liuba688/diansai-simulation/vision/training/analysis/assets/scene_0004_focus_sample.png

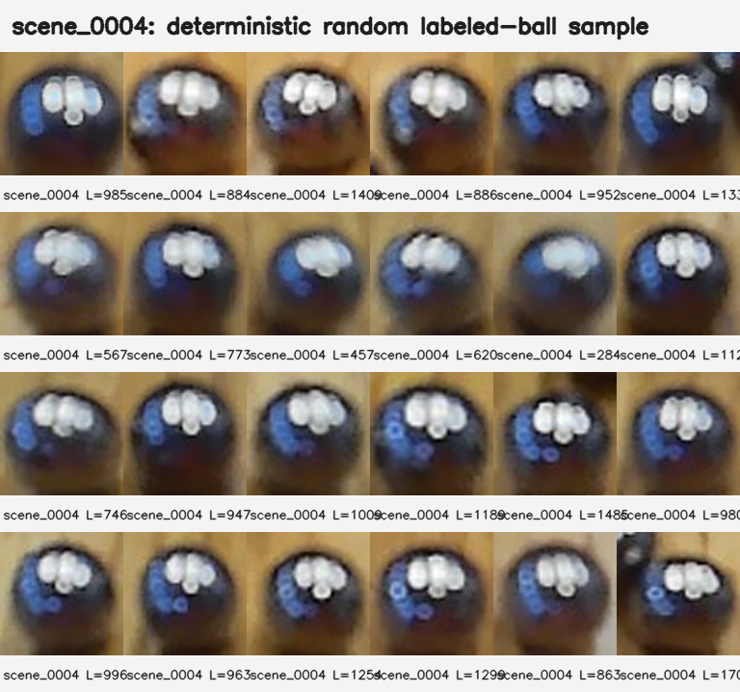
vision/training/analysis/assets/scene_0004_focus_sample.png
