liuba688/diansai-simulation/maixcam_ball_car/README.md

# MaixCAM 钢球视觉端

本目录保留完整钢球模型、目标跟踪、显示和 UART2 协议实现。视觉端只提供测量：
红框表示预警目标，绿框表示已连续确认并可进入控制。运动决策、速度闭环、倒退和
重新捕线均由 MSPM0G3507 执行。

通信为 UART1 115200，对接小车 UART2。当前系统不包含电磁铁或蓝牙控制。
