liuba688/diansai-simulation/PCB接线与引脚速查.md

# MSPM0G3507 终版小车 PCB 接线与引脚速查

> 用途：供人和 AI 快速查询板载接口、MCU 引脚及电气限制。后续开发优先查本文件，不从 Gerber 猜网络。  
> 原理图版本：`2026-06-13`，板名“2026电赛天猛星最终版”，V1.0。  
> 最后核对：2026-07-29（已与正式工程当前源码及 2026 H 题需求复核）。

## 1. 信息来源与使用规则

- **网络连接唯一依据**：`D:\ai embody\TI preparation\PCB\TI板卡\原理图文件\SCH_Schematic1_2026-06-13.pdf`
- **PCB 成品资料**：`D:\ai embody\TI preparation\PCB\TI板卡\Gerber2\10.zip`
- **工程引脚限制**：各工程下的 `project\尽量不要使用的引脚.txt`
- **实机修正优先级**：实机测量/已验证结果 > 2026-06-13 原理图 > 本文 > Gerber 丝印推断。
- 插头方向必须以 PCB 方形焊盘、数字 `1` 或连接器缺口确认；不要仅凭“从左到右”判断。
- 若本文与实物不一致，先停止上电并记录接口名、丝印、线序和测量结果，再更新本文。

## 2. 电源与共地

| 网络 | 用途 | 关键说明 |
|---|---|---|
| `12V_POWER` | 外部 12 V 输入开关前网络 | 经 U21 开关后成为 `12V` |
| `12V` | TB6612 VM、电机电源、UART3/UART5 电机兼容口 | 禁止接普通 5 V 串口模块 |
| `+5V` | TB6612 逻辑、编码器、OLED/IMU/部分接口供电 | USB-TTL 5 V 不得与已供电载板并联 |
| `VCC/3V3` | MSPM0 逻辑电源 | MCU GPIO 是否 5 V 容忍必须按器件资料确认 |
| `GND` | 全板公共地 | 外部电源、烧录器、USB-TTL 通信时必须共地 |

### 电源接口

| 接口 | 引脚/网络 | 用途 |
|---|---|---|
| U43（XT60） | 1=`12V_POWER`，2=`GND` | 主电源输入 |
| U21 | `12V_POWER` → 开关 → `12V` | 主电源开关 |
| U19 | IN+=`12V`，IN-=`GND`，OUT+=`+5V`，OUT-=`GND` | 12 V 转 5 V 模块 |
| CN14 | 1=`12V`，2=`GND` | 12 V 引出 |
| CN13 | 1=`+5V`，2=`GND` | 5 V 引出 |

### 上电安全

- 3S/12 V/5 V 链路和实车电机运行已验证，正式工程使用 `TB6612_OUTPUT_ENABLE=1`；上电默认 PWM=0。旧程序曾由蓝牙 `1` 启动并等待 3 秒，该流程与正式 H 题无关，比赛版必须改为实体按键启动并同步开始计时。
- 外部电源给 PCB 和电机供电时，烧录器只接 GND、SWDIO、SWCLK、NRST、VTref；关闭或断开烧录器 target power。
- 当前正式固件已停用 USB-TTL/UART3 调试、遥测和日志导出；比赛板不连接 USB-TTL。历史诊断接法仅供旧版本排障参考。
- 电机额定电流 1 A、堵转电流 2 A；当前已启用 TB6612 并完成实车巡线，后续高负载运行仍需观察电流和散热余量。

## 3. 当前正式功能引脚总表

| 模块/信号 | MCU 引脚 | 外设/功能 | 当前状态 |
|---|---|---|---|
| 历史调试 UART TX/RX | PB6/PB7 | UART1 | 正式固件不使用 |
| 历史 PID/日志 TX/RX | PB2/PB3 | UART3，板载 UART4 接口 | 正式固件不初始化、不收发；USB-TTL 停用 |
| 蜂鸣器 | PA7 | GPIO | 低电平触发 |
| OLED SCL | PA31 | 软件 I2C | 已验证 |
| OLED SDA | PA28 | 软件 I2C | 已验证 |
| IMU SCL | PA1 | 软件 I2C | 新 MPU6050 已完成通信、标定和 Angle Hold 实车验收 |
| IMU SDA | PA0 | 软件 I2C | 新 MPU6050 已完成通信、标定和 Angle Hold 实车验收 |
| IMU INT | PB4 | GPIO/中断 | 原理图已接，当前非必需 |
| 状态 LED | PB16 | GPIO | 当前程序心跳 |
| 核心板 LED | PA14 | GPIO | 与 MOTOR1 编码器 B 共用，不作为正式心跳 |
| 电机 PWM A | PA12 | TIMG0_C0 | TB6612 PWMA |
| 电机方向 AIN1 | PB19 | GPIO | MOTOR2 驱动方向；与正式 `tb6612.c` 一致 |
| 电机方向 AIN2 | PB17 | GPIO | MOTOR2 驱动方向；与正式 `tb6612.c` 一致 |
| 电机 PWM B | PA13 | TIMG0_C1 | TB6612 PWMB |
| 电机方向 BIN1 | PA16 | GPIO | MOTOR1 驱动方向 |
| 电机方向 BIN2 | PB24 | GPIO | MOTOR1 驱动方向 |
| MOTOR1 编码器 A | PA25 | GPIO 双边沿中断 | 已纠正并验证 |
| MOTOR1 编码器 B | PA14 | GPIO 双边沿中断 | 已纠正并验证 |
| MOTOR2 编码器 A | PA26 | GPIO 双边沿中断 | 已验证 |
| MOTOR2 编码器 B | PA27 | GPIO 双边沿中断 | 已验证 |
| CY-DXJ8 OUT1 | PB25 / H55-1 | GPIO 输入 | 新分配，待实测 |
| CY-DXJ8 OUT2 | PB18 / H55-2 | GPIO 输入 | 新分配，待实测 |
| CY-DXJ8 OUT3 | PB21 / H55-3 | GPIO 输入 | 新分配，待实测 |
| CY-DXJ8 OUT4 | PB22 / H55-4 | GPIO 输入 | 新分配，待实测 |
| CY-DXJ8 OUT5 | PA30 / H55-5 | GPIO 输入 | 新分配，待实测 |
| CY-DXJ8 OUT6 | PB0 / H55-6 | GPIO输入 | 新分配，待实测 |
| CY-DXJ8 OUT7 | PB1 / H55-7 | GPIO输入 | 新分配，待实测 |
| CY-DXJ8 OUT8 | PB14 / H55-10 | GPIO输入 | 新分配，待实测 |
| 菜单键 UP | PB13 / H56-4 | GPIO 输入、内部上拉 | 低电平按下，实机验证通过 |
| 菜单键 DOWN | PB23 / H56-3 | GPIO 输入、内部上拉 | 低电平按下，实机验证通过 |
| 菜单键 OK/比赛启动 | PB26 / H56-2 | GPIO 输入、内部上拉 | 低电平按下，实机验证通过 |
| 菜单键 BACK/急停 | PB27 / H56-1 | GPIO 输入、内部上拉 | 低电平按下，实机验证通过 |
| 摆杆执行器 PWM | PA22（U35） | TIMA0_C1 | H 题推荐预留，尚未接线和实测 |
| 摄像头数据 TX→主控 | PB3（UART3 RX） | 板载 UART4 的 RX 脚 | H 题推荐预留，联调时须先断开 USB-TTL |
| 主控数据 TX→摄像头 | PB2（UART3 TX） | 板载 UART4 的 TX 脚 | 可选；若摄像头只单向上传球坐标可不接 |

> “代码暂定/推荐预留”不等于已经完成接线。比赛新增模块接线后必须把本表状态改为“已实测”，同时记录接口方向、电压和通信参数。

## 4. 串口接口

### 普通 5 V 四针串口

| 板载接口 | 1 脚 | 2 脚 | 3 脚 | 4 脚 | MCU 外设 |
|---|---|---|---|---|---|
| UART0 | +5V | GND | RX=PA1 | TX=PA0 | UART0 |
| UART1 | +5V | GND | RX=PB7 | TX=PB6 | UART1 |
| UART2 | +5V | GND | RX=PA24 | TX=PA23 | UART2 |

- 当前正式比赛固件不启用 USB-TTL 调试串口。UART0/1/2 的历史实测结论保留，但不代表当前固件会输出数据。

### 电机兼容/特殊串口

| 板载接口 | 1 脚 | 2 脚 | 3 脚 | 4 脚 | 说明 |
|---|---|---|---|---|---|
| UART3 | TX=PA23 | RX=PA24 | GND | 12V | 与 UART2 共用信号，含 12 V |
| UART4（Zigbee） | +5V | RX=PB3 | TX=PB2 | GND | 实际对应 MCU UART3 |
| UART5 | TX=PB6 | RX=PB7 | GND | 12V | 与 UART1 共用信号，含 12 V |

> **高风险**：UART3/UART5 的 4 脚是 12 V，不是 5 V。普通 USB-TTL 不得插到这两个接口的电源脚。

## 5. TB6612 与双电机接口

### TB6612 模块排针

| TB6612 信号 | PCB 网络/MCU | 说明 |
|---|---|---|
| VM | 12V | 电机功率电源 |
| VCC | +5V | 逻辑电源 |
| GND | GND | 两侧均有地 |
| PWMA | PA12 / TIMG0_C0 | MOTOR2 PWM |
| AIN1 | PB19 | MOTOR2 方向 |
| AIN2 | PB17 | MOTOR2 方向 |
| AO1/AO2 | MOTOR2 M4/M3 | MOTOR2 电机两端 |
| STBY | +5V | 硬件常使能 |
| PWMB | PA13 / TIMG0_C1 | MOTOR1 PWM |
| BIN1 | PA16 | MOTOR1 方向 |
| BIN2 | PB24 | MOTOR1 方向 |
| BO1/BO2 | MOTOR1 M1/M2 | MOTOR1 电机两端 |

### 六针电机接口线序

以下为原理图符号**自上而下**的网络顺序；实际插线前仍须以 PCB 的 1 脚标识确认物理方向。

| 接口 | 自上而下网络顺序 | 编码器引脚 |
|---|---|---|
| MOTOR1 | `M2/BO2`、`+5V`、`A/PA25`、`B/PA14`、`GND`、`M1/BO1` | A=PA25，B=PA14 |
| MOTOR2 | `M4/AO1`、`+5V`、`A/PA26`、`B/PA27`、`GND`、`M3/AO2` | A=PA26，B=PA27 |

### 电机与编码器参数

- 减速比：56:1；额定转速：178 RPM。
- 额定电流：1 A；堵转电流：2 A。
- 额定转矩：6.5 N·m；最大转矩：9 N·m。
- 编码器推荐 5 V 供电，本体为 AB 两相；每电机轴 11 个 AB 周期。
- MCU 软件四倍频后理论输出轴计数：`11×56×4=2464 count/rev`。
- 两轴十圈实测平均：`2473.5 count/rev`；正式速度闭环按用户决定采用商家 `2450 count/rev`。
- 5 V 编码器的 AB 输出电平兼容性尚需确认：检查是否有板载调理、开漏上拉或 3.3 V 兼容输出。

## 6. 蜂鸣器、OLED 与 IMU

### 蜂鸣器 U3

| 引脚 | 网络 | 说明 |
|---|---|---|
| 1 | VCC/3.3V | 模块逻辑侧供电 |
| 2 | PA7 | 低电平触发 |
| 3 | GND | 地 |

### OLED

| 顺序 | 网络 | 说明 |
|---|---|---|
| 1 | GND | 地 |
| 2 | VCC | 电源 |
| 3 | SCL=PA31 | 软件 I2C |
| 4 | SDA=PA28 | 软件 I2C |

- 已验证为 SSD1306、128×64、I2C 地址 0x3C。

### IMU（U41，板上标注 MPU6050）

| 引脚 | 网络 | 当前用途 |
|---|---|---|
| 1 VCC | +5V | 模块供电 |
| 2 GND | GND | 地 |
| 3 SCL | PA1 | 软件 I2C SCL |
| 4 SDA | PA0 | 软件 I2C SDA |
| 5 XDA | NC | 未使用 |
| 6 XCL | NC | 未使用 |
| 7 AD0 | GND | I2C 地址选择为 0x68 |
| 8 INT | PB4 | 中断输出，当前非必需 |

- 当前模块为新换的 MPU6050/GY-521 类模块；I2C 7位地址为 `0x68`，驱动兼容 `WHO_AM_I=0x68`（MPU6050）和 `0x70`（MPU6500兼容器件）。当前新模块的实测身份值尚未单独留档，不得把旧模块的 `0x70` 当作新模块实测值。
- 配置：陀螺仪量程±2000 dps（16.4 LSB/(°/s)），加速度计量程±2 g（16384 LSB/g），DLPF约42 Hz，传感器采样率125 Hz，控制更新周期约10 ms。
- OLED菜单执行 `CALIBRATE YAW` 时整车必须静止；程序采集500点陀螺零偏和重力方向，用于倾斜安装下的车体竖直轴投影，耗时约2秒。
- Yaw符号约定（从车体上方俯视）：**逆时针旋转为正，顺时针旋转为负**。该约定已通过实车验证，禁止在接线或控制层再次反号。
- 当前正式角度比例系数为 `1.172`。Angle Hold实测：顺时针90°约`-90.7°`，逆时针90°约`+89.6°`，回到原朝向残差仅零点几度，已通过验收。

## 7. 舵机接口

四个 XH-3A 接口均为三针：1=信号、2=+5V、3=GND。

| 接口 | 1 脚信号 | 定时器通道 |
|---|---|---|
| U35 | PA22 | TIMA0_C1 |
| U39 | PA15 | TIMA0_C2 |
| U36 | PA17 | TIMA0_C3 |
| U34 | PA21 | TIMA0_C0 |

> PA21、PA23 属于核心板建议避免使用的特殊引脚；使用 PA21 舵机口前应核对核心板器件限制。

### H 题摆杆执行器推荐接法（尚未实测）

优先使用 U35，避免 PA21 特殊引脚：

| 执行器端 | 接到载板 | 说明 |
|---|---|---|
| PWM/S | U35-1，PA22 | TIMA0_C1；程序输出频率和脉宽必须与实际舵机匹配 |
| +5V/V+ | U35-2 或独立稳压 5～6 V | 小舵机可先空载测试；大扭矩舵机优先使用足够电流的独立稳压电源 |
| GND/- | U35-3/GND | 独立执行器电源必须与 MSPM0 载板共地 |

- 禁止把舵机接到 12 V。
- 禁止仅凭“5 V”判断板载降压模块一定带得动舵机；先测启动/堵转电流和 5 V 压降。
- 舵机首次测试必须拆下连杆或限制摆幅，确认中位和方向后再连接摆杆，防止顶死机构。
- 如果最终改用直流减速电机，不能直接接 PA22，必须增加合适的电机驱动器和位置反馈；确定器件后再补最终接线。

## 8. RGB 与扩展接口

### RGB 三针接口

| 接口 | 信号 | 电源 | 地 |
|---|---|---|---|
| U1 | PA14 | VCC | GND |
| U2 | PA18 | VCC | GND |
| U5 | PA2 | VCC | GND |

- PA14 同时连接核心板 LED，并在当前工程中作为 MOTOR1 编码器 B，不应再接 RGB 负载。

### 其余 IO

- H55：1=PB25，2=PB18，3=PB21，4=PB22，5=PA30，6=PB0，7=PB1，8=PB10，9=PB11，10=PB14。
- H56：菜单接线以载板实物方向和 2026-07-29 通断/上电实测为准：4=PB13，3=PB23，2=PB26，1=PB27。旧原理图摘录的编号方向与实物识别不一致，不再用于这四个菜单键。
- H51/H52/H53/H54/H60/H61 为辅助排针/引出位；原理图未给出统一功能名，未确认前不要按位置猜用途。

## 8.1 CY-DXJ8 八路灰度模块（当前正式方案）

CY-DXJ8 使用 `OUT1～OUT8 + 5V + GND` 共十根线，八路信号直接并行读取。OUT8 继续沿用 H55-10/PB14；PB10/PB11 不再作为当前菜单键：

| CY-DXJ8 | 载板/MCU | 软件位 | 方向 | 状态 |
|---|---|---:|---|---|
| `+5V` | CN13或可靠的载板`+5V` | - | 载板→模块 | 待接线 |
| `GND` | 载板`GND` | - | 共地 | 待接线 |
| `OUT1` | H55-1 / PB25 | bit7（最右） | 模块→MCU | 方向已确认 |
| `OUT2` | H55-2 / PB18 | bit6 | 模块→MCU | 方向已确认 |
| `OUT3` | H55-3 / PB21 | bit5 | 模块→MCU | 方向已确认 |
| `OUT4` | H55-4 / PB22 | bit4 | 模块→MCU | 方向已确认 |
| `OUT5` | H55-5 / PA30 | bit3 | 模块→MCU | 方向已确认 |
| `OUT6` | H55-6 / PB0 | bit2 | 模块→MCU | 方向已确认 |
| `OUT7` | H55-7 / PB1 | bit1 | 模块→MCU | 方向已确认 |
| `OUT8` | H55-10 / PB14 | bit0（最左） | 模块→MCU | 方向已确认 |

- 从车头朝前看，实物OUT8在最左、OUT1在最右；软件引脚表已反向排列，保持 `bit0=最左`、`bit7=最右`。
- 权重继续使用 `-350,-250,-150,-50,50,150,250,350`。
- **电平已实测**：白色地面输出低电平，黑线输出3.3 V高电平；当前 `LINE_SENSOR_ACTIVE_LEVEL=1` 和GPIO下拉输入配置正确。
- OUT高电平为3.3 V，可直接接MSPM0 GPIO，不需要额外分压或电平转换；模块电源仍接5 V并与载板共地。
- 先在轮胎离地状态观察 `mask/error`。从左到右扫过OUT8→OUT1时，预期掩码依次为 `01,02,04,08,10,20,40,80`；若按OUT1→OUT8扫描，则依次为 `80,40,20,10,08,04,02,01`。
- 旧 YB-MVX05 六线接法和已验收参数保留在历史文档和Git中，CY-DXJ8验收失败时可以回退。

## 8.2 四键菜单与比赛启动键（2026-07-31 当前配置）

正式工程恢复四个外部按键并关闭 B21 单键方案。四键配置为内部上拉、低电平按下；松开为高电平 `1`、按下为低电平 `0`。每个按键只需连接“对应 GPIO ↔ 按键 ↔ GND”，不得把按键另一端接 5 V。

| 功能 | MCU 引脚 | 电气接法 | H 题用途 |
|---|---|---|---|
| UP | PB13 / H56-4 | 按下时 PB13 与 GND 导通 | 菜单上移，已验证 |
| DOWN | PB23 / H56-3 | 按下时 PB23 与 GND 导通 | 菜单下移，已验证 |
| OK | PB26 / H56-2 | 按下时 PB26 与 GND 导通 | 确认/比赛启动，已验证 |
| BACK | PB27 / H56-1 | 按下时 PB27 与 GND 导通 | 急停/返回，已验证 |

- 四个信号连续位于 H56-4～H56-1，按键公共端接载板任意 GND。
- 短按事件在按键稳定释放后触发，建议按住约 0.1～0.5 s 后松开；UP/DOWN/OK 长按约 1 s 不会当作短按，BACK 长按用于停止。
- MOTOR2 编码器使用 `PA26/PA27`，菜单键使用 `PB26/PB27`，A/B 端口不同，不冲突。
- 曾用 `KEY TEST 0730` 诊断固件在 OLED 上逐键观察原始电平，四键均能正确切换；诊断模式随后关闭并恢复正式菜单。
- 题目要求实体按键启动时立即开始计时；旧蓝牙启动和 3 秒等待不能作为正式测试流程。
- 曾短暂尝试板载 B21 单键菜单，并把 OUT3 改到 PB10；该方案已撤销。当前 B21 恢复为 CY-DXJ8 OUT3，PB10 不用于 OUT3。

## 8.3 H 题摄像头、坐标通信与无线图传（推荐预留，尚未实测）

### 摄像头坐标到 MSPM0

HC-05 已正式放弃并应拆除/断开。需要摄像头通信时，复用板载 UART4（实际是 MCU UART3），并先断开 USB-TTL：

| 摄像头端 | 板载 UART4 | MCU | 说明 |
|---|---|---|---|
| TX | RX 脚 | PB3 / UART3 RX | 必接：摄像头向主控发送钢球位置 |
| RX | TX 脚 | PB2 / UART3 TX | 可选：主控发送目标位置或配置 |
| GND | GND | GND | 必须共地 |
| 电源 | +5V 或独立稳压电源 | - | 必须按摄像头铭牌确认，不能猜测 |

- 串口 TX/RX 必须交叉连接，通信双方统一波特率、数据位、停止位和校验方式。
- 接线前测量摄像头 UART 高电平，确认与 MSPM0 3.3 V GPIO 兼容；若输出为 5 V，必须加电平转换或分压。
- 摄像头只发送球坐标、有效标志和必要状态，不把视频流传入 MSPM0。
- 禁止 USB-TTL、摄像头或其他模块同时驱动 UART4，避免多个设备争用 PB2/PB3。

### 无线图传

- 图传发送模块和摄像头固定在车上；接收模块、显示和存储设备置于环形线路外。
- 图传画面必须覆盖整个 25 cm 摆杆，能看清钢球和刻度，并能完整录像、回放。
- 图传模块供电电压、极性和工作电流必须按实际型号标注后再接；当前没有确定型号，因此本文不能给出电源针序。
- 若图传与控制摄像头是两套设备，可以共用机械支架，但电源容量需分别核算；使用同一车载电源时必须共地并检查干扰。

## 8.4 当前整车接线完整性清单

| 子系统 | 接线说明是否完整 | 备注 |
|---|---|---|
| 主电源/5 V降压/共地 | 是 | 已实车验证 |
| TB6612与双电机 | 是 | 本次已纠正 AIN1/AIN2 文档顺序 |
| 双编码器 | 是 | 5 V输出电平裕量仍属长期风险 |
| CY-DXJ8 | 部分实测 | 十线并行接法、白底低/黑线3.3 V高、OUT8最左/OUT1最右已确认；整车巡线待验收 |
| OLED/蜂鸣器/UART1日志 | 是 | 已验证 |
| 四键 | 是 | PB13/PB23/PB26/PB27，松开1、按下0，OLED菜单实测正常 |
| 摆杆舵机 | 推荐方案已给出 | PA22/U35 尚未实测，最终执行器未冻结 |
| 摄像头坐标串口 | 推荐方案已给出 | PB2/PB3 尚未实测，联调时需先断开 USB-TTL |
| 无线图传 | 否 | 型号和针序未知，取得实物后必须补录 |
| MPU6050/HC-05 | 历史接线完整 | HC-05 已放弃并断开；MPU6050 与正式 H 题无关 |

## 9. 核心板 80 Pin 对照

| Pin | 网络 | Pin | 网络 | Pin | 网络 | Pin | 网络 |
|---:|---|---:|---|---:|---|---:|---|
| 1 | GND | 2 | GND | 41 | GND | 42 | +5V |
| 3 | PA0 | 4 | PA28 | 43 | GND | 44 | 3V3 |
| 5 | PA1 | 6 | PA31 | 45 | RST | 46 | PA18 |
| 7 | PA8 | 8 | PB4 | 47 | PB11 | 48 | PB14 |
| 9 | PA9 | 10 | PB5 | 49 | PB10 | 50 | PA7 |
| 11 | PB15 | 12 | PA10 | 51 | PB0 | 52 | PB1 |
| 13 | PB16 | 14 | PA11 | 53 | PA30 | 54 | GND |
| 15 | PB2 | 16 | PB12 | 55 | PB21 | 56 | PB22 |
| 17 | PB3 | 18 | PB13 | 57 | GND | 58 | +5V |
| 19 | DIO | 20 | CLK | 59 | GND | 60 | 3V3 |
| 21 | GND | 22 | 3V3 | 61 | PA2 | 62 | PA23 |
| 23 | GND | 24 | +5V | 63 | PB19 | 64 | PA21 |
| 25 | PB6 | 26 | PB7 | 65 | PB17 | 66 | PB18 |
| 27 | PB8 | 28 | PB9 | 67 | PA16 | 68 | PA17 |
| 29 | PA12 | 30 | PA13 | 69 | PA14 | 70 | PA15 |
| 31 | PB23 | 32 | PB26 | 71 | PB20 | 72 | PA22 |
| 33 | PB27 | 34 | PA29 | 73 | PB25 | 74 | PB24 |
| 35 | AGND | 36 | CHIP | 75 | PA25 | 76 | PA24 |
| 37 | GND | 38 | 3V3 | 77 | PA27 | 78 | PA26 |
| 39 | GND | 40 | +5V | 79 | GND | 80 | GND |

## 10. 核心板建议避免使用的引脚

- 建议避免：PA23、PA21、PA19、PA20、PA5、PA6、PA4、PA3。
- PA14 连接核心板 LED；当前又作为 MOTOR1 编码器 B，禁止再分配其他功能。
- 若必须使用 PA23/PA21，核心板说明要求移除 R8、R9、C14、C15 后才可正常使用；实际操作前必须再次核对核心板原理图。
- 载板虽然已将 PA23 引到 UART2/UART3、PA21 引到舵机 U34，但“已布线”不等于“可无条件使用”。

## 11. 已确认的易错点

- 旧记录曾把 MOTOR1 编码器写成 PA24/PA25；**正确值是 PA25/PA14**。
- 板载 `UART4` 是接口编号，实际对应 MCU UART3（PB2/PB3）。
- UART3 与 UART2 共用 PA23/PA24，但 UART3 接口带 12 V。
- UART5 与 UART1 共用 PB6/PB7，但 UART5 接口带 12 V。
- UART0 PA0/PA1 当前已被 IMU 软件 I2C 使用，正式调试串口必须用 UART1。
- 旧 IMU 已出现 `WHO_AM_I=FF`、三轴全零并明显发烫，当前已移除且禁止再次上电；LED 亮不代表芯片正常。
- 替换件选标准 GY-521 MPU6050，必须逐针确认顺序为 `VCC/GND/SCL/SDA/XDA/XCL/AD0/INT`，并确认排母插入方向使 VCC 对 VCC。相同针序反向插入仍会烧毁。
- 新模块首次只接控制板，先核对实际供电、电流、温升和 I2C 响应；确认正常后再接电机。新 GY-521 通常为 `WHO_AM_I=0x68`，软件需兼容旧模块的 0x70 和新模块的 0x68。
- MOTOR1/MOTOR2 与整车左右轮、正 PWM 与前进方向的关系仍须装车实测，不能仅凭接口编号推断。

## 12. AI 修改代码前检查清单

1. 先查“当前正式功能引脚总表”，确认没有重复占用。
2. 涉及电源时明确写出 3.3 V、5 V 或 12 V，不使用含糊的 `VCC` 代替。
3. 涉及 UART3/UART5 时先提示其接口含 12 V。
4. 涉及电机时确认主电源、左右轮映射、PWM 方向、编码器符号及 `TB6612_OUTPUT_ENABLE=1`。
5. 涉及编码器时固定使用 MOTOR1=PA25/PA14、MOTOR2=PA26/PA27。
6. 涉及 IMU 时保留 PA0/PA1，不把调试 UART 改回 UART0。
7. 新发现的实机线序或原理图差异必须同时更新本文件和《调试日志.md》。
