liuba688/diansai-simulation/开发进度.md

# MSPM0G3507 终版小车开发进度

> 本人和队友的逐日开发记录已合并到《开发历程合并时间线.md》。本文原有内容完整保留；
> 后续不得用短摘要覆盖历史，只能按日期追加或修正“当前状态”。

> 更新日期：2026-07-29
> 本文件只记录当前有效状态、已完成里程碑和真正未完成事项；历史排错过程见《调试日志.md》。
 AI工具每次做完任务必须及时更新文档，包括旧的内容更改和新的内容添加
> 2026-07-29 正式赛题已经发布。下文以 H 题为唯一主线；保留但不直接服务于本题的旧功能统一标记为“**与赛题无关**”，比赛期间暂停投入时间。

## 当前执行总计划（2026-07-29，后续调试以此为准）

### 分工与总体原则

- **本人：底盘与巡线主线**。2026-07-29 决定正式改用 CY-DXJ8 八路并行数字灰度，保留已经通过实车验证的双轮速度闭环和巡线外环结构，重新验收黑白电平、左右顺序和巡线参数；随后完成实体按键启动、OLED 计时、A 点终点识别、速度规划和停车偏差收敛。
- **队友：MaixCAM 视觉主线**。摄像头朝下，画面只覆盖水管和钢球；完成球心检测、像素到毫米标定、滤波、速度估计、丢球判断和串口输出。
- **共同完成：摆杆与滚球闭环**。先完成执行器中位、正负方向、角度限幅和开环测试，再完成静态回中、`O→+5 cm→-5 cm`、A-B 动态平衡、整圈中心平衡和任意指定位置。
- 三条线并行推进，不等视觉完全结束才测试执行器，也不等巡线全部结束才冻结通信协议。视觉未完成时用模拟坐标测试主控；主控未完成时视觉端用电脑串口记录验证。
- 每一步都设置独立验收门，验收通过后保存固件、参数、串口日志、照片和视频，不用单次最好结果代替重复测试。

### 接口冻结

MaixCAM 向 MSPM0 输出一维物理坐标，不再沿用旧“地面钢球接近/拾取”语义：

| 字段 | 定义 |
|---|---|
| `sequence` | 帧序号，用于发现丢帧或旧帧 |
| `position_mm` | 水管中心为 0，画面左侧为负、右侧为正 |
| `velocity_mm_s` | 滤波后的钢球轴向速度 |
| `confidence` | 视觉置信度 |
| `valid` | 本帧位置是否可用于控制 |
| `fault` | 丢球、越界或视觉内部故障 |
| `crc` | 串口帧校验 |

- 视觉检测与发送目标频率：30～50 Hz；MSPM0 滚球控制先使用 20 ms 周期。
- 超过 100～200 ms 无有效新帧、连续丢球或坐标越界时，小车停车，摆杆限速回中并报警。
- MaixCAM 和 USB-TTL 调试必须使用互不冲突的串口资源；HC-05 已放弃并应断开，最终接线前重新核对 MCU 端引脚，禁止多个设备共用 PB2/PB3。

### 分步实施与验收门

| 步骤 | 主责 | 工作内容 | 通过标准 |
|---:|---|---|---|
| 0 | 共同 | 机械、电气和供电确认；测整车投影、铰点高度、执行器型号及零位；固定相机支架 | 整车≤35×25 cm，`h≥5 cm`；球自由滚动；执行器双向动作不复位、不掉线 |
| 1 | 本人 | 加装当前机构后的巡线基线复测 | 40/55/70 RPM 分档测试；最终装载状态连续 5 圈不脱线 |
| 2 | 队友 | MaixCAM 检测、毫米标定、滤波、丢球判断 | `-100～+100 mm` 多点测试；静止抖动目标≤2 mm、至少≤5 mm；全程误差≤5 mm |
| 3 | 共同 | 摆杆执行器开环控制 | 中位、正倾、负倾方向正确；软件初期限幅约±3°，连续往复无卡滞和过热 |
| 4 | 共同 | 模拟坐标与串口联调 | 正负方向、单位、超时、CRC和异常帧处理全部正确，暂不驱动滚球闭环 |
| 5 | 共同 | 静态中心回稳 | 从±5 cm及更远位置可回中；先达到±2 cm，再达到±1 cm |
| 6 | 共同 | 静态 `O→+5→-5 cm` 状态机 | 全过程≤5 s，±5 cm目标附近最大误差绝对值≤1 cm，连续通过5次 |
| 7 | 本人 | A点计时、终点识别和精确停车 | 一圈≤20 s；停车误差先≤5 cm，再收敛到≤2 cm；连续记录10次 |
| 8 | 共同 | A-B直线动态平衡 | 从20 RPM逐步提速；AB≤8 s，球中心误差绝对值≤1 cm |
| 9 | 共同 | 低速整圈到正式速度 | 20/30/40 RPM逐级测试，再提高到整圈≤30 s且中心误差≤1 cm |
| 10 | 共同 | 整圈任意指定位置 | 先开放 `-50～+50 mm`；目标平滑变化，整圈≤30 s且误差≤1 cm |
| 11 | 共同 | 图传、录像、报告和封存检查 | 实时画面覆盖整杆；每次完整录像可回放；测试数据和接收设备齐全 |

### 巡线调试的立即执行顺序

1. CY-DXJ8 黑白电平已经实测：白色地面为低电平，黑线为3.3 V高电平，可直接接MSPM0；代码保持 `LINE_SENSOR_ACTIVE_LEVEL=1` 和输入下拉。
2. 接入后先不开电机，逐路验证 `OUT1～OUT8` 和左右方向；实物已确认 `OUT8=车头视角最左侧`、`OUT1=最右侧`，因此软件规定 `bit0=OUT8`、`bit7=OUT1`。
3. 保持已验收的速度 PI 和巡线外环结构，先只替换八路采样驱动；架空验证左右轮与编码器方向。
4. 落地从 20 RPM 开始，依次测试 20、30、40、55 RPM；新模块完成全赛道验收前不直接恢复旧 70 RPM。
5. 每档至少完整跑 3 圈，记录时间、脱线点、掩码、误差和电机/驱动温升；每次只修改一个巡线参数。
6. 基础巡线稳定后再加入按键计时和 A 点识别，终点识别采用启停线图样加最短时间/里程门控。

### 远程调速规则

- 当前不使用无线遥控；PID 参数与速度测试通过 USB-TTL 有线工具完成，输入继续做范围检查，不能直接写 PWM。
- 推荐命令为 `SPD,55`、`ACC,10`、`DEC,15`、`TARGET,0`、`SAVE`、`STOP`，每条命令返回 `OK` 或具体错误。
- **正式比赛模式禁止行驶中遥控**。启动、停止和模式切换统一使用实体按键；比赛时断开所有调试通信模块。
- 远程日志限频，建议不超过 10 Hz，避免串口打印破坏 10/20 ms 控制周期。

### 实物图核对结论

以下仅记录两张 2026-07-29 实物图能够确认的事实：

- DIY 双轮差速底盘、前后牛眼轮、上层载板、灰度传感器、摆杆本体及其车载支撑已经装车。
- 白色水管摆杆已水平布置在车体上方；一端可见金属合页/铰接结构，另一侧可见执行机构和长连杆/传动结构，已经不是“尚未加工摆杆”的阶段。
- 车体上已有较高的蓝色竖直孔梁，顶端平板预备用于安装 MaixCAM；当前照片中尚未看到 MaixCAM 本体。
- 计划中的最终视角为相机垂直向下，只包含整根水管和钢球；相机必须固定在车身支架上，不随摆杆转动。
- 照片显示高立柱较细长，最终装相机前需要增加横向桥架或三角斜撑，并整理悬垂排线，降低行驶振动和线束牵扯造成的坐标抖动。
- 从照片不能可靠确认整车投影尺寸、铰点到平台的高度、PPR 管精确长度、执行器型号/零位/额定电压、摄像头视野和支架固有振动；这些项目仍须尺量和上电实测，不能按照片估算后直接标记合格。

## 项目位置

- 当前工作区：`D:\ai embody\diansai start!\diansai-simulation`
- 正式工程：`D:\ai embody\diansai start!\diansai-simulation\project\MSPM0G3507_Car`
- Keil 工程：`project\MSPM0G3507_Car\project\mdk\SeekFree_MSPM0G3507_Device_Library.uvprojx`
- 主程序：`project\MSPM0G3507_Car\project\user\src\main.c`
- 正式赛题：`2026_H题_车载平衡滚球运动控制系统.pdf`
- `before the final car` 仅为学长车 PID 历史测试副本，不是当前开发基线。

## 2026 正式赛题：H 题车载平衡滚球运动控制系统

竞赛时间为 2026-07-29 08:00 至 2026-08-01 20:00。作品是在现有循线小车上增加 25 cm PPR 凹槽摆杆、钢球、摆杆角度控制机构、摄像头位置检测和无线图传。

### 主要得分指标

| 项目 | 验收指标 | 分值 |
|---|---|---:|
| 图传 | 实时显示完整摆杆画面，每次测试可录像和回放 | 6 |
| 基础循线停车 | A 点按键启动，顺时针一圈，≤20 s，停车偏差≤2 cm，并显示总时间 | 16 |
| 静态滚球 | `O → +5 cm → -5 cm`，全过程≤5 s，±5 cm 最大误差绝对值≤1 cm | 13 |
| A 到 B 动态平衡 | AB 1.5 m 行驶≤8 s，钢球保持中心误差绝对值≤1 cm | 20 |
| 整圈中心平衡 | 一圈≤30 s，钢球中心误差绝对值≤1 cm | 20 |
| 整圈任意位置平衡 | 一圈≤30 s，钢球稳定在任意指定位置，误差绝对值≤1 cm | 20 |
| 设计报告 | 方案、理论、电路程序、测试数据、规范性 | 20 |

赛道为 1.5 m 直线加半径 0.5 m 半圆组成的环形黑线，总长约 6.14 m；黑线宽 `1.8±0.2 cm`。A 点有一条与环路垂直、长 5 cm 的启停线。车体不得超过 `35 cm × 25 cm`，循迹只能使用红外光电模块，钢球位置检测必须使用摄像头。

### 当前赛题技术路线

1. 保留已验收的双轮速度闭环和八路红外循线作为底盘基线。
2. A 点启停线采用八路灰度特殊图样识别，并结合最短时间/里程门控防止起步误判；按键启动即开始计时，过一圈后制动停车。
3. 摆杆左端使用铰链/合页，距小车平板高度 `h≥5 cm`；右端由舵机或减速电机主动改变倾角，摆杆不能固定死。
4. 摄像头从摆杆上方检测钢球横坐标，完成像素到厘米标定；位置误差经 PD/PID 产生小角度摆杆指令。
5. 位置识别和无线图传若无法由同一设备稳定兼顾，则 MaixCAM 负责识别，独立无线图传负责实时画面、录像和回放。
6. **2026-07-29 最新方案变更**：正式比赛改用铺线识别和抗干扰表现更好的 CY-DXJ8；采用八路并行GPIO读取，保留已验收的加权误差、巡线外环和速度PI。YB-MVX05作为可回退历史基线。

## 2026-07-29 原始待办与三人分工（已由文首当前执行总计划取代）

今天的总验收目标是形成两个可独立演示的闭环：一是“按键计时—循线一圈—A 点停车”，二是“摄像头测球—执行器倾杆—钢球回中/定点”。

| 人员 | 主责 | 今天必须交付 |
|---|---|---|
| 1 号：底盘与主控 | （原计划，已被文首新计划取代）保持当时的 YB-MVX05 接线和扫描程序；实体按键启动；OLED 计时；A 点启停线识别；时间/里程门控与停车制动 | 历史安排，仅保留时间线；当前按 CY-DXJ8 八路并行方案执行 |
| 2 号：机械与执行器 | 按题目加工 25 cm PPR 摆杆；左端铰链和 `h≥5 cm` 支撑；右端舵机/减速电机连杆；安装摄像头、刻度和防滚落挡片；检查车体尺寸、重心及供电 | 钢球可自由滚动，摆杆无卡滞且能双向小角度倾斜；机构牢固，整车不超过35×25 cm |
| 3 号：视觉与滚球控制 | 摄像头识别钢球；像素—厘米标定；输出位置和有效标志；位置滤波；实现 `O→+5→-5 cm` 状态机和位置 PD/PID；验证图传录像 | 连续稳定输出球坐标；静止车上可回中并完成一次 +5/-5 cm 动作；录像可回放 |

### 今日推荐时间节点

- **上午**：冻结执行器、视觉和图传方案；复核 YB-MVX05 现有接线及 8 路掩码；机械尺寸定稿并开工。
- **下午前半段**：底盘跑通 8 路读取及基础循线；机械执行器可控；视觉能输出厘米坐标。
- **下午后半段**：分别调通 A 点停车闭环和静态滚球闭环。
- **晚上**：装车低速联调，检查供电、重心、摄像头抖动和机构松动；保存视频、串口日志、误差数据及结构照片作为报告素材。

## 当前项目状态

终版双轮小车已经完成主控工具链、烧录、板载外设、双电机驱动、双编码器、速度闭环、旧 YB-MVX05 八路灰度接入以及自适应巡线，用户已完成实车验证并确认巡线效果稳定。根据 2026-07-29 实物图，摆杆、铰接/传动结构和高位相机预留支架已经形成实物并装车，但 MaixCAM 本体尚未出现在照片中，支架抗振、最终尺寸、执行器标定和供电仍未验收。当前主线是最终装载状态巡线复测、A 点精确停车、视觉钢球坐标、摆杆闭环和无线图传。

HC-05 双向通信已正式放弃；MPU6050 车体航向保持和自动直角转弯属于此前通用平台预研，标记为“**与赛题无关**”并暂停。

## 项目开发路径

**底盘工具链 ✅ → 双电机速度闭环 ✅ → YB-MVX05 八路灰度循线 ✅ → 弯道/急弯/丢线处理 ✅ → 摆杆实物初装 ✅ → 最终装载巡线复测 ← 当前 → A点停车/视觉坐标/执行器开环 → 静态滚球 → 动态整车联调**

- **已放弃**：HC-05 双向启停与遥测；保留历史记录，不再接入实车调试。
- **与赛题无关**：MPU6050 车体航向角保持、自动 90°直角转弯；仅保留已有代码，不继续调试。

- 实车不是“等待接入灰度”或“等待基础循迹”阶段；这两项已经完成。
- 当前主线是保持已验收巡线基线，按赛题增加功能；若需要提速，每次只把直线速度提高 5 RPM 并复测全赛道。

## 当前硬件映射

| 功能 | 当前有效映射 |
|---|---|
| 左轮 | MOTOR1 编码器 PA25/PA14 + TB6612 B |
| 右轮 | MOTOR2 编码器 PA26/PA27 + TB6612 A |
| 电机 PWM/方向 | A：PA12/PB19/PB17；B：PA13/PA16/PB24 |
| 调试串口 | 正式固件已停用 USB-TTL/UART3 输出、输入和日志导出 |
| HC-05 / USB-TTL | 均已放弃并断开；PB2/PB3 当前不由正式固件初始化 |
| OLED | SSD1306，PA31/PA28 软件 I2C，地址 0x3C |
| 蜂鸣器 | PA7，低电平触发 |
| OLED 四键 | UP=PB13、DOWN=PB23、OK=PB26、BACK=PB27（H56-4～1），内部上拉、低电平按下 |
| CY-DXJ8 OUT1～OUT4 | PB25/PB18/PB21/PB22（H55-1～4） |
| CY-DXJ8 OUT5～OUT8 | PA30/PB0/PB1/PB14（H55-5/6/7/10） |

CY-DXJ8 使用八路并行数字输入。2026-07-29 已确认实物 `OUT8` 为车头视角最左侧、`OUT1` 为最右侧，因此软件反向排列为 `bit0=OUT8`、`bit7=OUT1`，继续保持左负右正权重。白色地面为低电平、黑线为3.3 V高电平，可直接接MSPM0。

## 已验收实车固件参数

| 类别 | 当前参数 |
|---|---|
| 电机 | 56:1，178 RPM，额定电流 1 A、堵转电流 2 A |
| 编码器换算 | `2450 count/rev` |
| 基础循环 | 10 ms |
| 测速/速度 PI 周期 | 20 ms |
| 双轮速度 PI | KP=10、KI=1.0、KD=0 |
| 速度滤波 | `alpha=0.25` |
| 输出限幅 | 8000 |
| 起步补偿 | 1000 |
| 直线巡线速度 | 最近已验收基线 70 RPM；最终装载后从 55 RPM 保守复测 |
| 普通弯速度 | 2026-07-29 代码调整为 50 RPM，待实车复测 |
| 急弯 | 外轮 50 RPM、内轮 -12 RPM，待实车复测 |
| 丢线搜索 | 外轮 22 RPM、内轮 -10 RPM，最多 200 ms |

## 已验收实车巡线行为

1. 上电保持停车；通过 OLED 实体按键选择并启动任务，BACK 键立即停车。
2. 八路灰度以 `-350～350` 权重计算位置误差。
3. 普通弯按误差和误差变化率立即降低基础速度；回正后逐渐恢复速度。
4. 外轮不会因转向修正而超过当前基础速度；内轮可减速、停止或反转。
5. 最外侧连续命中 20 ms 后进入急弯状态，中心通道稳定 30 ms 后退出。
6. 丢线后沿最后一次误差方向搜索 200 ms，仍未找到才停车。
7. 正式比赛固件不输出串口日志；状态和菜单通过 OLED 查看。

## 已完成里程碑

- **2026-07-23**：Keil/Arm Compiler 6、CMSIS-DAP、LED、UART、蜂鸣器和 OLED 实机通过。
- **2026-07-23**：MPU-6500 兼容芯片识别与零偏校准完成。
- **2026-07-23**：TB6612 底层和双编码器四倍频解码完成；MOTOR1 引脚纠正为 PA25/PA14。
- **2026-07-23**：自有电机十圈标定平均约 2473.5 count/rev；正式闭环按用户决定采用商家 2450 count/rev。
- **2026-07-25**：左右轮、驱动通道和编码器反馈符号完成实车校正。
- **2026-07-25**：30 RPM 闭环误差约 1%；20/30/60/100 RPM 架空测试均稳定，最高 duty 不到 6000。
- **2026-07-25（历史阶段）**：当时曾记录 HC-05 PB2/PB3 `1/0` 启停通过；后续复测确认 MCU→HC-05 方向持续乱码，最终于 2026-07-30 放弃该方案。
- **2026-07-26**：YB-MVX05 接入终版载板，完成八路扫描、加权位置误差和巡线外环。
- **2026-07-26**：完成动态弯道降速、外轮限速、急弯状态机和丢线恢复；用户实车确认巡线完美。
- **2026-07-26**：巡线直线速度继续提高到 70 RPM，用户确认实车稳定；70 RPM 作为当前速度基线。
- **与赛题无关｜2026-07-26**：`Car_angle` 已加入 MPU6050/MPU6500 兼容角度累计、角度 PID 和编码器里程计；本题滚球位置必须由摄像头检测，因此该车体航向角功能暂停。
- **与赛题无关｜2026-07-26**：安装状态下采用实测比例系数 1.268 后，手动旋转 90° 显示 89.7°；该标定不用于滚球位置闭环。
- **与赛题无关｜2026-07-26**：曾修复角度调试时 HC-05 乱码/不稳定；本题行驶中不得遥控，蓝牙不作为正式比赛控制链路。
- **与赛题无关｜2026-07-26**：停车抗扰测试期间旧 IMU 损坏；已有故障保护保留，但比赛期间不继续投入时间。
- **2026-07-27**：已更换灰度传感器并恢复循线。同期更换 MPU6050 的工作标记为“与赛题无关”。
- **2026-07-27**：新灰度传感器巡线已恢复正常；此前 OLED 显示 `M00` 且小车不走的原因是灰度 `OUT` 信号线漏接。补接 `OUT→PB22` 后黑线检测与巡线实车正常。
- **与赛题无关｜2026-07-28**：HC-05 单向乱码诊断及 `bluetooth_self_test()` 保留为历史调试代码，正式比赛版本应禁用上电自检，避免阻塞启动。
- **2026-07-29**：完成《PCB接线与引脚速查》赛题接线审计，补全 YB-MVX05 六线接法、四键低电平接法、PA22/U35 摆杆舵机推荐接法、PB2/PB3 摄像头串口推荐接法及图传供电约束；同时纠正文档中 TB6612 AIN1/AIN2 顺序，使其与正式代码 `AIN1=PB19、AIN2=PB17` 一致。
- **2026-07-29**：四个自备轻触开关最终接入 H56-4～1，对应 PB13/PB23/PB26/PB27；实测松开=1、按下=0，UP/DOWN/OK/BACK 均可正常操作 OLED 菜单。PB8/PB9/PB10/PB11 暂定方案作废。
- **2026-07-29**：确认实际开发工程为 `D:\ai embody\diansai start!\diansai-simulation`；曾因修改同名旧工作区 `TI preparation` 导致固件未生效，后用 `KEY TEST 0730` 明确定位并完成纠正。
- **2026-07-29**：巡线直线速度保持 70 RPM；普通弯道基础速度和急弯外轮目标提高到 50 RPM。Keil 编译 0 error、0 warning，尚待装车复测弯道稳定性。

## 当前待办与风险

以下按正式 H 题重新排序：

- **方案变更｜CY-DXJ8 正式接入**：2026-07-29 根据实际铺线识别和抗干扰表现，撤销此前“取消 CY-DXJ8”的结论，正式改用 `OUT1～OUT8 + 5V + GND` 八路并行输出。
- **P0｜CY-DXJ8 接线与验收**：OUT1～OUT8 分配为 PB25、PB18、PB21、PB22、PA30、PB0、PB1、PB14；已确认白底低、黑线3.3 V高，下一步验证八路左右顺序，再从20 RPM开始恢复巡线。旧 YB-MVX05 作为已验收回退方案保留，不删除历史记录。
- **P0｜A 点精确停车和计时**：实体按键启动即计时；OLED 显示总时间；使用启停线图样加最短时间/里程门控识别一圈终点，完成主动制动并把小车中心轴线上唯一测试点的停车偏差调至≤2 cm。
- **P0｜摆杆机械与执行机构验收**：实物图已确认摆杆、铰接/传动结构和高位相机预留支架初装完成；下一步实测 25 cm PPR 管、`h≥5 cm`、整车投影、执行器型号/零位/电压、双向小角度动作和支架抗振。摆杆不得固定死，槽内不得做增摩擦改造。
- **P0｜摄像头钢球位置闭环**：完成整杆视野、像素到厘米标定、坐标滤波、丢球保护和位置 PD/PID，先实现静态回中，再完成 `O→+5→-5 cm`。
- **P0｜图传和录像**：接收端必须置于赛道外，画面覆盖整个摆杆，可实时显示、完整录像并回放；接收显示存储设备需要与作品一起封存。
- **P0｜动态整车联调**：从低速开始验证钢球中心稳定，再依次测试 A-B、整圈中心和整圈任意位置；每轮保存时间和最大位置误差。
- **P0｜设计报告数据**：从第一天开始保存电路框图、程序流程、机械尺寸、控制模型、每轮时间/误差、照片和视频，避免最后一天补造数据。
- **P0｜补齐新增实物最终针序**：四键针序已完成实测；摆杆执行器具体型号、摄像头型号和无线图传型号仍未冻结，取得实物后必须测量电压、确认针序。
- **与赛题无关｜暂停｜验收新 MPU6050**：车体航向角保持不属于本题硬性要求。
- **与赛题无关｜暂停｜修复 MPU 运动累计误差**：不影响红外循线和摄像头滚球闭环。
- **已放弃｜HC-05 与 USB-TTL 调试**：HC-05 存在乱码/连接超时；两块板又在接入 USB-TTL 后先后出现按钮异常。2026-07-31 决定正式固件停用 UART3 初始化、PID 串口命令、遥测和日志导出，比赛板不再连接 USB-TTL。
- **与赛题无关｜暂停｜自动直角转弯**：本题赛道是连续环线，没有十字路口或指定 90°转弯。
- **P1｜巡线速度复测**：直线 70 RPM 为既有稳定基线；2026-07-29 将普通弯和急弯外轮提高到 50 RPM，必须复测缓弯、急弯、丢线恢复和驱动温升，未验收前保留旧参数回退能力。
- **P1｜核对 TB6612 电流与温升余量**：电机额定 1 A、堵转 2 A；长期高负载运行时继续观察驱动器、电机和导线温升，禁止人为堵转。
- **P2｜确认编码器 5 V 输出电平裕量**：当前实机工作正常，但仍建议核对 AB 输出是否经过板载调理或符合 MSPM0 GPIO 电平要求。
- **风险｜供电冲突**：载板已有主电源或核心板 USB 供电时，不连接 USB-TTL 的 5 V；烧录器和载板必须共地。
- **风险｜接口编号混淆**：板载 UART4 实际对应 MCU UART3（PB2/PB3）；带 12 V 的 UART3/UART5 不作为普通串口使用。

## 后续改动原则

- 已验收的巡线参数作为当前安全基线，不同时大幅修改速度、PD、急弯和丢线参数。
- 只提速时优先修改 `LINE_FOLLOW_STRAIGHT_RPM`。
- 修改灰度板安装方向或线序后，必须重新确认 bit0～bit7 的左右顺序。
- 修改速度 PI 周期后必须同步重新整定 KI 和滤波参数。
- 新的实车结论需同步更新本文件、总档案、接线速查和调试日志。

## 2026-07-29～30：速度闭环自动测试与高速实测

### 已完成

- 新增 `tools/pid_test/` PC 工具，可自动扫描串口、握手、启停、采集并保存 LOG/CSV/JSON，计算稳态误差、超调、调节时间、波动、轮速差、饱和率、采样率和综合评分。
- 固件新增 `@PID` 遥测帧及 `PING/START/STOP/ENCODER/GAINS` 命令；PID 调试口改为 MCU UART3 PB2/PB3（载板插座标 UART4），外接 USB-TTL 为 COM9、115200。COM17 不是当前 PID 数据口。
- 已加入 PC 异常停止、固件超时停止、编码器失速保护和本地停止，安全不依赖 PC。
- 原左轮电机/编码器反馈异常，更换组件后闭环恢复。
- 已支持运行时 PID 修改和最多 6 轮有界自动调参；运行时参数仅写 RAM。

### 当前基线

- 左右轮 PID：`Kp=12, Ki=1, Kd=0`；输出限幅 `9000`。
- 编码器 `2450 counts/rev`，周期 `20 ms`，滤波系数 `0.25`。
- 巡线直线 `80 RPM`，普通弯 `50 RPM`，急弯外轮 `50`、内轮 `-12 RPM`；正常启动延迟仍为 `3 s`。
- 最新 HEX：`project/MSPM0G3507_Car/project/mdk/Objects/SeekFree_MSPM0G3507_Device_Library.hex`，2026-07-30 11:00 构建，0 error / 0 warning。

### 结果与下一步

- 25 RPM 自动调参最佳 `12/1/0`，82.3 分；10 RPM 为 81.1 分；40 RPM 约 81.8 分。
- 旧限幅 8000 时，80 RPM 约 59.5 分、100 RPM 约 49.8 分，分别约 59% 和 76% 饱和。限幅 9000 后最近一次 80 RPM 约 77.6 分，但有效稳态仅约 4.34 s，仍需复测。
- 赛道一圈约 `6.142 m`，实车约 `50 s`。当前 80/50 RPM 理论运动约 29 s，加启动延迟约 32 s；额外约 18 s 主要来自修正、急弯、丢线及负载下转速不足。
- 下一步优先把启动延迟降至约 0.5 s，把普通弯速分步升至 65、70～75 RPM，并量化各巡线状态耗时；之后再评估直线 90～100 RPM。
- 转弯辅助应使用偏航角速度阻尼，不使用固定航向角保持。蓝牙暂时放弃，继续用 COM9 USB-TTL。
## 2026-07-30 完赛时间第一轮优化

- 菜单巡线任务的启动延迟由 3 s 缩短为 0.5 s；PID 阶跃测试仍保留独立的 1 s 安全等待。
- 直线目标保持 80 RPM，普通弯基础速度由 50 RPM 提高到 65 RPM；急弯仍为外轮 50 RPM、内轮 -12 RPM，丢线策略不变，便于单变量实车验收。
- 巡线耗时统计拆分为直线、普通弯、急弯、丢线四类，按 10 ms 控制周期累计，并记录每类状态进入次数。
- 停车时通过 COM9 有线串口输出一次 `@LINESTAT,1` 摘要；PID 遥测升级为 `@PID,3`，PC 工具继续兼容 v1/v2。未启用或修改蓝牙链路。
- Keil Arm Compiler 6.24 编译通过：`0 Error(s), 0 Warning(s)`，HEX 已更新。下一步需在安全场地先跑 65 RPM 普通弯，核对冲线、摆动、急弯误触发和四类耗时，再决定是否升到 70/75 RPM。

### 2026-07-30 极限速度试验档

- 按用户要求将直线目标由 80 RPM 提高到 100 RPM，普通弯最大速度由 65 RPM 提高到 80 RPM；普通弯最低速度仍为 65 RPM，因此会根据巡线误差在 65～80 RPM 之间动态变化。
- 急弯 50/-12 RPM、丢线搜索 22/-10 RPM、0.5 s 菜单任务启动等待和四状态耗时统计均保持不变。
- 本档仅用于安全场地极限测试，不替代已验证基线；需重点观察输出长期饱和、电池压降、电机/驱动温升、冲线和丢线。

### 2026-07-30 新电池提速与离线巡线日志

- 用户更换 12.5 V 新电池；旧电池已降至 10.8 V。`SPEED_PID_OUTPUT_LIMIT` 确认仍为 9000，本轮不改变限幅。
- 直线目标提高到 120 RPM；普通弯按误差在 75～90 RPM 之间变化；急弯和丢线参数保持不变。
- 巡线期间取消 50 Hz 实时 PID 串口帧，改为 MCU RAM 内 10 Hz 紧凑记录。加入偏航角速度后为保留栈和运行余量，最终容量调整为600条/60秒。记录时间、左右目标与实际速度、左右输出、灰度掩码、巡线误差、四类状态和偏航角速度。
- 停车路径先停止电机，再自动发送 `@RUNLOG`；日志在 RAM 中保留到下一次巡线开始。电脑未监听时可稍后发送 `@PIDTEST,DUMP` 重读。
- 新增 `tools/pid_test/download_run_log.py`，可通过 COM9 将上一圈保存为 CSV。未使用蓝牙或片内 Flash，避免 Flash 擦写寿命和行驶期间阻塞。
- Keil 编译通过：Code=49912、RO-data=3516、RW-data=224、ZI-data=32400，0 error、0 warning。

### 2026-07-30 巡线迟滞优化与弯道融合方案

- 上一圈日志显示有效运动36.3秒，其中普通弯33.2秒、急弯3.1秒、有效直线0秒；输出最高仅约4600，慢速主因是“小误差也立即封顶90 RPM”，而非9000输出限幅。
- 新增普通弯迟滞：误差强度达到90才进入普通弯限速，回落到60才退出。小误差时继续按 `120 - 0.1×强度` 运行，例如强度50可请求约115 RPM，不再立即压到90 RPM。
- 急弯确认/退出由20/30 ms改为50/50 ms，抑制上一圈31个短促急弯片段。
- 当时暂不启用固定航向角闭环接管弯道：彼时底盘轮距未记录、新IMU尚未完成比例标定；目前轮距和IMU均已标定，但纯角度/里程轨迹仍会受轮滑和入弯偏差累积影响。
- 推荐后续结构为“赛道曲率对应的左右轮速度和目标偏航角速度前馈 + IMU角速度阻尼 + 灰度低增益连续纠偏 + 丢线保护”。新日志已加入 `yaw_rate_dps`，用于下一圈识别半圆弯目标角速度。
- Keil编译通过：Code=49992、RO-data=3516、RW-data=224、ZI-data=22800，0 error、0 warning。

### 2026-07-30 底盘几何实测与Angle Hold修复

- 实测驱动轮距209 mm，灰度预瞄距离218～220 mm（代码取219 mm），相邻探头10 mm、八探头总跨度70 mm。
- 带载滚动10圈前进1950 mm，因此有效轮周长195 mm、有效轮径约62.07 mm；里程计已由旧66 mm假设改为该实测周长。
- 标准半圆中心半径500 mm时，内外轮轨迹半径为395.5/604.5 mm，理论内外轮速度比约0.654；若车体中心目标90 RPM，则约为内轮71.2、外轮108.8 RPM。参数已入代码但曲率前馈暂未启用。
- Angle Hold此前进入时沿用旧累计Yaw作为显示/目标，且运行中使用不带静止漂移补偿的快速更新。现改为进入时相对角度归零，Angle Hold期间使用完整IMU更新；普通巡线仍使用快速更新。
- Keil编译通过：Code=50032、RO-data=3516、RW-data=224、ZI-data=22800，0 error、0 warning。

### 2026-07-30 IMU曲率前馈融合

- 新IMU的0°、90°、360°已通过实车验收，普通弯开始启用IMU融合。
- 标准500 mm半圆使用90 RPM车体中心速度前馈，按209 mm轮距生成内外轮约71.2/108.8 RPM；正式任务固定顺时针，因此两个半圆均使用右转前馈，灰度误差只做正负微调，不能决定曲率方向。
- 灰度普通弯反馈改为较小叠加量（KP=0.04、KD=0.05、半差修正限幅8 RPM），持续纠正横向偏差。
- 理论目标偏航角速度约33.5°/s。IMU使用角速度幅值闭环，KP=0.20 RPM/(°/s)，半差修正限幅6 RPM；急弯和丢线保持原安全策略优先。
- RUNLOG DATA升级为v3，增加 `yaw_rate_dps` 与 `yaw_rate_target_dps`。
- Keil编译通过：Code=50660、RO-data=3520、RW-data=224、ZI-data=22808，0 error、0 warning。

### 2026-07-30 正式赛道直线/圆弧状态机

- 对比日志：手贴赛道有效行驶约34.0秒，标准赛道约28.8秒；但两圈分别有107/109次状态切换。标准赛道仍有1.8秒短暂丢线，说明卡顿不只是铺线不圆，也来自普通弯前馈按瞬时误差反复开关。
- 两圈 `yaw_rate_target_dps` 全为0。根因是本次上电未执行 `CALIBRATE YAW`，`is_calibrated` 未置位，IMU融合保护条件未通过。
- 正常路径关闭旧急弯状态入口，不再执行50/-12 RPM反转式急转；状态简化为直线、标准圆弧和丢线恢复。
- 入弯要求误差强度连续80 ms达到门限；进入后用IMU总Yaw锁定圆弧。累计转角≥160°且灰度连续50 ms居中才退出，避免前馈开关振荡。
- 正常直线/圆弧目标增加4 RPM/10 ms斜坡限制；丢线安全目标仍立即生效。
- 首次启动LINE ONLY/BALL VISION若IMU未就绪，会显示保持静止并自动校准；失败则拒绝启动。
- Keil编译通过：Code=51140、RO-data=3552、RW-data=224、ZI-data=22824，0 error、0 warning。

### 2026-07-30 启停横线误触发修复

- `run_20260730_173901.csv` 显示启动约0.1秒出现非连续掩码25、误差-116，持续满足入弯确认；下一采样在灰度已回中时仍锁定右弯，导致直线上输出约114/66 RPM并迅速丢线。
- 根因是启停横线/复合图样被当作圆弧入口，不是IMU方向错误；本圈IMU目标33.5°/s已正常启用。
- 增加运动开始后前0.5秒圆弧识别抑制，并要求入弯灰度掩码为连续成片图样；分离多点图样如25不能触发圆弧。
- Keil编译通过：Code=51272、RO-data=3548、RW-data=224、ZI-data=22832，0 error、0 warning。

> 更正：用户确认车辆在启停线之后释放，不能把mask25归因于启停横线。根因是横向误差不能可靠表示赛道曲率。上述0.5秒/掩码保护不足以从原理上解决，自动圆弧融合现已关闭。

### 2026-07-30 安全回退

- `LINE_FOLLOW_ARC_FUSION_ENABLE=0`：暂时关闭基于灰度误差触发的固定右转前馈和IMU圆弧角速度闭环。
- 保留120 RPM直线、75～90 RPM误差降速、灰度连续纠偏、无急弯反转、4 RPM/10 ms目标斜坡、丢线保护、IMU自动校准与日志。
- 下一版必须使用里程/赛道阶段判定圆弧，不能再用横向误差判定曲率。
- Keil编译通过：Code=51116、RO-data=3552、RW-data=224、ZI-data=22832，0 error、0 warning。

### 2026-07-30 启停线自动停车

- 小车在5 cm启停线前释放：第一次检测横线只置起点并清零里程，第二次检测才停车，避免刚起步立即结束。
- 横线判定为至少5路灰度同时有效并连续30 ms；普通1.8 cm黑线通常仅命中1～3路。
- 第一次横线后里程不足550 cm时禁止终点触发；赛道中心线全长约614.2 cm。
- 第二次满足条件时先执行电机停车，再输出 `@FINISH,1,STOP`、状态摘要和RUNLOG。
- 自动圆弧融合继续关闭。
- Keil编译通过：Code=51428、RO-data=3616、RW-data=224、ZI-data=22832，0 error、0 warning。

### 2026-07-30 MPU6050角度比例初次实车标定

- 菜单校准后，Yaw回零重复性良好，方向定义为顺时针负、逆时针正。
- 根据顺时针360°平均残差+46.3°和逆时针360°约-59°，将新IMU角度比例由1.000初调为1.172，以平衡两个方向的尺度误差。
- Keil编译通过：Code=50060、RO-data=3520、RW-data=224、ZI-data=22800，0 error、0 warning；待烧录后完成双向各三圈复测，再决定是否继续修正比例或零偏。
- 烧录后的90°实测为顺时针约-90.7°、逆时针约+89.6°，回原朝向残差仅零点几度。新IMU比例1.172已通过实车验收并作为当前正式参数。
- 本次测试即为 `Angle Hold` 模式实车验收；角度比例、方向、回零和保持效果均通过，`Angle Hold` 当前标记为已完成。
- Yaw符号正式冻结为：从车体上方俯视，逆时针为正、顺时针为负；所有后续航向和角速度控制统一使用该约定。

### 2026-07-30 晚间：启停线与入弯轮速跟随优化

- `run_20260730_181153.csv` 有317条记录，丢线状态66条。典型入弯中目标已降至约90/64.5 RPM，实际仍约127.7/125.3 RPM，确认增量式速度PI保留直线阶段输出是入弯冲出的重要原因。
- 启停线由至少5路/30 ms改为至少4路/20 ms；第一次确认仍只清零里程，550 cm后第二次确认才停车。
- 首版处理按目标比例释放PI输出。`run_20260730_192755.csv` 中丢线降至1条，入弯跟随明显改善；但直线120 RPM目标下实际平均仅约81.9/79.3 RPM，说明灰度目标频繁波动造成PI输出被反复削弱。
- 当前版取消比例释放，改为目标每下降1 RPM释放8 PWM、每次最多80 PWM；目标加速仍为4 RPM/10 ms，减速改为2 RPM/10 ms，兼顾启动速度和入弯连续性。
- 最近日志只有起点一次6路命中，后程没有4路及以上图样。终点未识别不能继续简单归因于门槛过高，暂不降到3路，避免普通弯3路图样误触发。
- 下一圈需提供直线、开始入弯、完全进弯、开始出弯、完全回直线及卡顿的大致时刻，用于对齐灰度、轮速、IMU和里程；状态机不得使用固定时间脚本。
- 最新编译：Code=51648、RO-data=3620、RW-data=224、ZI-data=22832，0 error、0 warning。

### 2026-07-30 23:36：满负载巡线进入20秒

- 最终验收日志为 `output/run_logs/run_20260730_233651.csv`，用户确认满负载实车完美完成任务。
- 约18.0 s检测到终点宽线并进入停车对齐，赛道巡线时间进入20 s；后续负轮速为终点倒车寻线与IMU回正，不计入巡线时间。
- 219条日志全部为普通巡线状态，`mask=0`为0，没有触发正转或反转丢线搜索。
- 正式稳定参数：直线160 RPM、普通弯92～115 RPM、巡线KP=0.20、最大纠偏75 RPM。
- 高速入弯采用10 RPM/10 ms目标减速；单步下降达到8 RPM时，PI输出按8 PWM/RPM释放、单次最多160 PWM。
- 满负载问题已闭环；下一阶段接入视觉模块和步进电机后，先复测重复性，不立即继续提速。
- 最新Keil构建：Code=53596、RO-data=3728、RW-data=224、ZI-data=22848，0 error、0 warning。
