liuba688/diansai-simulation/终版小车信息总档案.md

# MSPM0G3507 终版电赛小车信息总档案

> 本档案已恢复为融合前的完整版本。双分支逐日开发历程和 2026-07-29 最终取舍见
> 《开发历程合并时间线.md》；当前融合软件架构另见 `docs/`。

> 建档日期：2026-07-22  
> 最近更新：2026-07-26（八路灰度自适应巡线实车验收）
> 当前状态：两轮编码器循迹基础平台已经完成并通过实车巡线验收；后续按赛题扩展并逐步提速。

## 1. 项目目标和范围

- 用途：电赛基础小车平台，后续根据赛题少量增加模块、修改 PID 参数及巡线逻辑。
- 第一阶段项目均已完成：
  - MSPM0G3507 工程建立、编译和烧录；
  - 双电机驱动与方向校正；
  - 左右编码器读取；
  - 左右轮速度闭环；
  - 八路灰度读取；
  - 基础循迹与实车整定；
  - OLED 状态显示；
  - 蜂鸣器状态提示；
  - MPU6050 通信、校准，并按任务需要用于定角或航向辅助；
  - USB 转 TTL 调试输出。
- 暂缓：MaixCAM 视觉。该部分由队内另一名成员负责。
- 当前不需要：避障、坡道及其他尚未明确的附加功能。
- 赛道规格：尚未确定。程序结构需要便于赛题公布后替换巡线逻辑。
- 工作原则：先稳定跑通，学习作为伴随目标；每天整理进度、接线、代码、测试结果、故障和下一步任务。

## 2. 主控和载板

- 主控：MSPM0G3507 核心板，插在排母上，可拆卸。
- 载板：`PCB/TI板卡`，现有原理图日期为 2026-06-13。
- 下载器：Horco CMSIS-DAP。
- 开发环境、逐飞 MSPM0G3507 开源库和终版小车专用 Keil 工程均已建立并完成编译、烧录和实机运行。
- 开发路线已经确定：Keil MDK + Arm Compiler 6 + TI MSPM0 SDK/SysConfig + MSPM0 DFP + Horco CMSIS-DAP，以逐飞库的 MDK 工程和例程作为竞赛开发框架。
- Horco CMSIS-DAP v2 的 SWD 识别、编译、烧录和运行链路已经通过 LED 及后续整车固件验证。

### 2.1 已安装开发环境

核验日期：2026-07-23。

| 项目 | 当前版本或状态 | 安装位置 |
|---|---|---|
| Keil MDK / µVision | 5.43.1 | `D:\software\keil5` |
| 旧 Keil 备份 | 5.24a，仅作安装器自动备份 | `D:\software\keil5\Backup.001` |
| Arm Compiler 6 | `armclang.exe` 文件版本 20.0.0git | `D:\software\keil5\ARM\ARMCLANG` |
| Arm Compiler 5 | 5.06，保留供旧工程使用 | `D:\software\keil5\ARM\ARMCC` |
| MSPM0 SDK | 2.11.00.07 | `D:\software\TI\mspm0_sdk_2_11_00_07` |
| SysConfig | 1.26.2+4477 | `D:\software\TI\sysconfig` |
| MSPM0 Keil DFP | `MSPM0G1X0X_G3X0X_DFP` 1.3.1 | `D:\software\keil5\ARM\PACK\TexasInstruments\MSPM0G1X0X_G3X0X_DFP\1.3.1` |
| 下载器 | Horco CMSIS-DAP v2；曾枚举 COM10 | USB 设备 |
| Git | 已安装 | `D:\software\Git` |
| VS Code | 已安装，仅作为编辑器/辅助工具 | `D:\software\Microsoft VS Code` |

DFP 已验证包含 MSPM0G350X SVD、128KB MAIN Flash 算法和 NONMAIN Flash 算法，Keil Pack Installer 中能够检索并选择 MSPM0G3507。

当前用户环境变量 `MSPM0_SDK` 和 `SYSCONFIG` 尚未持久设置。逐飞原生工程不一定依赖这两个变量，但使用速度闭环参考工程的一键配置脚本时，需要重新设置并完成 SysConfig 生成验证。SDK 2.11.00.07 要求 SysConfig 不低于 1.26.0，当前 1.26.2 满足要求。

### 2.2 逐飞 MSPM0G3507 开源库

- 本地路径：`D:\embodied materials\MSPM0G3507_Library`
- 远程仓库：`https://gitee.com/seekfree/MSPM0G3507_Library.git`
- 当前分支：`master`
- 核验提交：`a9a11b3ecfa3b8adf5819e25382ee56f8d35b8b1`
- 主模板工程：`SeekFree_MSPM0G3507_Opensource_Library\project\mdk\SeekFree_MSPM0G3507_Device_Library.uvprojx`
- 逐飞说明要求 MDK 5.37 及以上；当前 Keil 5.43.1 满足要求，并支持 DAP v2。
- 库中已有 GPIO、UART、ADC、PWM、PIT、外部中断、定时器、编码器、电机、OLED、IMU、无线通信等 MDK 例程。
- 建立终版工程时应复制模板或最接近的例程到本项目工作区，不直接在逐飞 Git 原仓库中开发。

### 2.3 原理图中的电机控制信号

| 功能 | MSPM0G3507 引脚 |
|---|---|
| PWMA | PA12 |
| AIN1 | PB19 |
| AIN2 | PB17 |
| PWMB | PA13 |
| BIN1 | PA16 |
| BIN2 | PB24 |
| STBY | 原理图接 +5V |

### 2.4 原理图中的编码器信号

| 电机接口 | 编码器信号 |
|---|---|
| MOTOR1 | PA25、PA14 |
| MOTOR2 | PA26、PA27 |

实车最终映射：左轮=MOTOR1(PA25/PA14)+TB6612 B，右轮=MOTOR2(PA26/PA27)+TB6612 A。

### 2.5 载板 UART 接口编号与实际信号

核验日期：2026-07-23。已对照现有原理图、`Gerber2` 中 10 份打板文件的器件信息和实物测试结果。

载板上印刷的 `UART0`～`UART5` 是物理接口名称，不一定等于 MSPM0G3507 内部 UART 外设编号。当前实物测试确认的信号关系如下：

| 载板丝印 | MSPM0 外设与信号 | 当前用途 |
|---|---|---|
| UART0 | UART0，TX=PA0，RX=PA1 | 可用于 USB-TTL 调试 |
| UART1 | UART1，TX=PB6，RX=PB7 | 可用备用串口 |
| UART2 | UART2，TX=PA23，RX=PA24 | 可用备用串口；供电脚为 5V |
| UART3 | 与 UART2 共用 PA23/PA24，但带 12V 供电脚 | 为可能使用的四线电机预留，本车不用 |
| UART4 | UART3，TX=PB2，RX=PB3 | 当前仅接 USB-TTL 做有线 PID/遥测调试；HC-05 已放弃并断开 |
| UART5 | 与 UART1 共用 PB6/PB7，但带 12V 供电脚 | 为可能使用的四线电机预留，本车不用 |

重要注意事项：

1. 用户已复核并更正：实物 UART2 的供电脚为 5V，与现有原理图一致。
2. 串口信号映射已通过四路固件和 USB-TTL 实测：PA0、PB6、PA23、PB2 均能正常发送。
3. UART3 和 UART5 带 12V，不作为普通 USB-TTL 调试口使用，也不纳入本车方案。
4. 后续接线必须优先依据用户实物丝印，并在连接供电脚前用万用表确认电压；不得只依据接口名称或旧版 PDF。
5. 当载板已经通过核心板 USB 或主电源供电时，USB-TTL 只接 GND、TX/RX 信号，不连接 USB-TTL 的 5V。
6. 普通单向日志接线为：载板 TX → USB-TTL RX、载板 GND → USB-TTL GND；USB-TTL TX 和电源脚可以悬空。

## 3. 电机、编码器和车轮

- 电机：JGB680/MG680 编码器减速电机 ×2，两只完全相同。
- 额定电压：12V。
- 电机外径：约 37mm。
- 输出轴：6mm D 型轴。
- 编码器：AB 相增量式方波输出。
- 编码器基础脉冲：电机转子每圈 11 脉冲。
- 输出轴单路基础脉冲数：`11 × 实际减速比`。
- 编码器供电范围：3.3～5V；当前 PCB 电机接口提供 +5V。
- 已确认减速比 56:1、额定转速 178 RPM、额定电流 1 A、堵转电流 2 A；正式闭环采用商家 `2450 count/rev`。
- 配套车轮：实测/当前采用直径约 66mm，6mm D 轴连接件。
- 两个 6Pin 电机插头能够插入 PCB 的 MOTOR1/MOTOR2 接口，用户确认线序一致；首次上电前仍要按接口丝印逐根复核。

### 3.1 六线定义

| 颜色 | 定义 |
|---|---|
| 红 | 电机 + |
| 白 | 电机 - |
| 蓝 | 编码器 VCC |
| 黑 | 编码器 GND |
| 黄 | 编码器 A 相 |
| 绿 | 编码器 B 相 |

交换红、白可以改变电机旋转方向。不要通过交换编码器电源线改变方向。

### 3.2 驱动兼容性风险

TI PCB 使用一颗 TB6612，A/B 两通道分别驱动一只电机。TB6612 官方输出能力为每通道平均 1.2A，3.2A 只允许作为很短的峰值。JGB680 的启动及堵转电流未知，因此目前不能认定驱动电流一定具有足够余量。

正式测试要求：

1. 首次测试架空车轮；
2. 从较低 PWM 开始，并使用斜坡逐渐增加占空比；
3. 每次测试时间保持很短，观察 TB6612、电机及导线温度；
4. 禁止人为堵转车轮来测试；
5. 若出现难以起步、驱动反复保护、主控复位或 TB6612 快速发热，立即断电并改用更大电流驱动器；
6. 后续优先向卖家取得堵转电流，或使用带限流功能的电源测量。

## 4. 底盘

- 底盘：DIY 双轮差速底盘，已经完成装配和实车巡线。
- 结构：两只驱动轮 + 前后两个牛眼轮。
- 底盘已装配；轮距和轴距尚未记录，当前仅明确灰度板预瞄距离约 7～8 cm。
- 灰度板位置：车头前方，位于驱动轮轴线前约 7～8 cm；当前安装位置已通过实车巡线验证。
- 四点支撑需要检查是否发生前后牛眼轮高度不一致造成驱动轮悬空或接地压力不足；必要时用垫片调整高度。

### 4.1 2026 H题摆杆与相机支架实物状态

根据 2026-07-29 两张整车实物图：

- 白色水管摆杆、金属合页/铰接件、另一侧执行机构与长连杆/传动结构已经安装到车体，不再属于纯方案设计阶段。
- 车体已经安装高位蓝色孔梁和顶端安装板，预备用于固定 MaixCAM；照片中尚未看到 MaixCAM 本体。
- 最终相机固定在车身支架上并垂直向下，只拍摄完整水管和钢球，不允许跟随摆杆转动。
- 高位立柱细长，装相机前应增加横向桥架或三角斜撑；排线需要固定并留出运动余量，避免振动和线束牵扯形成虚假球位移。
- 当前照片不能代替尺寸与电气验收。仍需实测车体投影≤35×25 cm、铰点高度 `h≥5 cm`、PPR 管长度25 cm、执行器型号/额定电压/零位、摆杆最大角度、相机整杆视野和供电压降。
- 初期控制建议软件限幅约±3°，机械保护约±5°；上电、视觉超时和丢球时均应限速回到水平中位。

## 5. 电池和供电

- 电池：3S 锂聚合物航模电池。
- 标称电压：11.1V。
- 满电电压：12.6V。
- 容量：2200mAh。
- 当前实测电压：11.2V。
- 接口：XT60。
- 充电器：iMaxRC B3 PRO Compact Charger，支持 2S/3S 平衡充电。
- 主电源开关和整车供电链路已经投入实车运行。
- 板载可调降压模块：焊死在 PCB 上。
- 其余 LM2596：留作备用。
- 四节 AA 电池盒：是否使用根据后续需求决定，默认不纳入终版主供电。

### 5.1 当前供电状态

以下完整主供电路径已经在电机闭环和实车巡线中投入运行：

`3S 电池 → XT60 → 电源开关 → 12V 网络 → 板载降压模块 → +5V`

仍需遵守供电隔离：载板已有主电源或核心板 USB 供电时，不连接 USB-TTL 的 5V；烧录器只保留信号、地和电压检测连接，避免多个电源同时驱动同一网络。

### 5.2 主电源首次上电前检查

1. 确认开关焊盘实际数量和连通方式；若 PCB 是三焊盘转换开关位，两脚开关必须接公共端和其中一个有效端；
2. 断开核心板和所有可插拔模块；
3. 检查 12V-GND、5V-GND 是否短路；
4. 接入开关后做断电通断测试；
5. 首次仅接 3S 电池，测量 12V 网络；
6. 空载调节并确认降压输出为 5.0V 左右；
7. 确认极性和电压正确后再逐个插回核心板、OLED、MPU6050等模块。

## 6. 已确定的外设

| 模块 | 当前决定 |
|---|---|
| 灰度传感器 | 2026-07-29 正式改用 CY-DXJ8 八路并行数字输出；旧 YB-MVX05 实车结论保留为回退基线，新模块等待电平、左右顺序和全赛道验收 |
| OLED | 使用，显示速度、灰度误差、PID参数和故障状态；不单独显示“上电” |
| IMU 模块 | 旧兼容模块损坏后已移除；2026-07-27 已更换 MPU6050/GY-521 类模块。I2C地址0x68，SCL=PA1、SDA=PA0；驱动接受WHO_AM_I=0x68/0x70，比例1.172，Angle Hold已通过实车验收 |
| TMB12A05 蜂鸣器 | 已装；确认是 5V 有源蜂鸣器，PA7 控制，低电平触发，实测正常 |
| LED | PB16 已用于程序心跳状态 |
| MaixCAM | 队友负责视觉主线；高位安装支架已形成实物，相机本体、最终视野、串口针序和供电仍待安装实测 |
| HC-05 | **已放弃调试使用**；无线连接虽能建立，但 MCU→模块方向持续乱码、虚拟 COM 连接也不稳定，不再投入时间排查 |
| USB 转 TTL | **正式固件已停用**；UART3 PB2/PB3 不初始化、不输出，比赛板不连接 USB-TTL |

终版 MSPM0G3507 已完成 X1～X8 地址扫描、黑线高电平识别、左右顺序确认、加权误差、动态速度巡线、急弯和丢线恢复；用户实车确认当前巡线效果完美。

## 7. 建议的软件和调试结构

### 7.1 控制层次

1. 电机 PWM 和方向底层；
2. 左右编码器计数及速度计算；
3. 左右轮独立速度 PID；
4. CY-DXJ8 八路并行读取及加权位置误差；
5. 巡线外环产生左右目标速度；
6. 丢线、启动失败、编码器异常和超时保护；
7. MPU6050 仅在基础闭环稳定后加入定角转弯或航向保持。

### 7.2 调参方式顺序

1. 程序内固定参数：用于单模块测试；
2. 四个外部按键：UP=PB13、DOWN=PB23、OK=PB26、BACK=PB27，用于启动、停止和模式切换；
3. OLED：用于菜单和低频状态显示；
4. USB-TTL、UART3 PID 命令、遥测和日志导出均已停用；
5. HC-05 方案已放弃；如后续确需无线回传，应另立独立通信任务并重新完成电平、供电和抗干扰验收。

### 7.3 速度闭环参考工程的复用结论

参考资料：

`D:\embodied materials\keil5环境配置\环境配置压缩包\速度闭环\My_M0_Proj\M0_Templant_FreeRTOS`

该目录是一个带 Git 历史的 MSPM0G3507 + FreeRTOS 工程，当前分支为 `speed-only`，核验提交为 `836a6860a7bef9ff3e807e23cb37f51dbd251549`。它有较高参考价值，但不能整套不经核对直接替换终版工程。

可直接借鉴的部分：

- `Component/control/speed_loop_core.*`：速度环纯算法与硬件层分离；10ms 采样、50ms 控制窗口、RPM 整数换算、一阶低通、目标斜坡、增量式 PID 和低速启动前馈。
- `Component/pid/pid.*`：增量式 PID 整数实现和“先累加、再限幅”的正确限幅逻辑。
- `Component/service/speed_service.*`：编码器、控制算法和 TB6612 之间的硬件适配层。
- `Component/tb6612/*`：双电机方向、PWM、制动接口的模块化写法。
- `Component/encoder/*`：硬件 QEI 与 GPIO 软件正交解码并用、16 位计数器溢出处理、累计计数和增量快照接口。
- `Component/task/*` 和 `FreeRTOSConfig.h`：任务、队列、通知以及控制周期组织方法。
- `Component/UART/*`：UART0 日志和重定向。
- `Component/oled/*`：软件 I2C OLED，可规避 OLED 与 MPU6050 同占 I2C0 外设的冲突。
- `main.syscfg`、`ti_msp_dl_config.*`：80MHz 时钟、PWM、QEI、UART、I2C、GPIO 和 10ms 定时器配置方式。
- `setup_mspm0_env.bat`、`scripts\setup_mspm0_env.ps1`、`keil\syscfg.bat`：自动修补本机 SDK include/lib 路径并在 Keil Build 前生成 SysConfig 代码的思路。
- `docs\工程总结.md` 和 `docs\工程分享与环境配置手册.md`：环境迁移、速度环/yaw 环调试、ISR 与任务分工、故障排查和工程分享清单。

必须适配或重新验证的部分：

1. 参考工程的编码器引脚为硬件 QEI `PA26/PA27`，另一路 GPIO 软件解码 `PA25/PA14`；重新目视核对终版 PCB 原理图并结合逐相实测后，确认终版载板同样是 MOTOR1 `PA25/PA14`、MOTOR2 `PA26/PA27`。旧档案曾误记为 MOTOR1 `PA24/PA25`，现已纠正。
2. 参考工程的电机方向引脚名称与终版原理图存在 AIN1/AIN2 顺序差异；最终以原理图表格和实车正转测试为准。
3. 参考工程写有 `ENCODER_COUNTS_PER_REV = 440`，并在部分注释中另述 30:1 减速比和 13200 计数，不适用于当前已确认 56:1 的 JGB680；正式程序采用商家 `2450 count/rev`。
4. 参考工程的 PID、前馈、斜坡和 yaw 参数来自另一套电机、底盘、负载和地面，只能作为结构参考，终版车必须低速重新整定。
5. `main.syscfg` 原始元数据是 MSPM0 SDK 2.04.00.06 + SysConfig 1.23.1；分享脚本/文档后来按 SDK 2.10.00.04 + SysConfig 1.26.2 验证。当前机器是 SDK 2.11.00.07 + SysConfig 1.26.2，需重新运行生成、编译和烧录验证。
6. 文档中包含 MPU6050 DMP、yaw 角闭环、PB21 目标角切换等总结，但当前 `speed-only` 分支的实际源文件应逐项核对；文档描述不能替代源代码和实车验证。

历史实施顺序（现已完成，不是当前待办）：

1. 以逐飞 MDK 模板建立终版工程，完成 LED、UART、PWM和定时器基础验证。
2. 先移植参考工程的纯算法 `pid` 与 `speed_loop_core`，使用固定输入验证。
3. 按终版 PCB 引脚重写 TB6612 和双编码器硬件适配层。
4. 架空车轮确认左右映射、正转计数符号和每圈计数，再启用速度闭环。
5. 速度闭环稳定后接入 OLED、IMU 和巡线外环；当前工程未引入 FreeRTOS。
6. 灰度巡线逻辑已在终版工程中独立开发完成；参考工程只提供速度闭环结构参考。

### 7.4 当前正式工程的 TB6612 底层

建立日期：2026-07-23。

- 已新增独立 `tb6612.c/.h`，并加入 Keil 工程。
- 当前引脚按终版原理图配置：
  - PWMA=PA12、AIN1=PB19、AIN2=PB17；
  - PWMB=PA13、BIN1=PA16、BIN2=PB24。
- PWM 使用 20kHz，占空比接口范围为 -10000～10000。
- `TB6612_OUTPUT_ENABLE=1`，供电、正反转、架空闭环和实车巡线均已验证。
- 上电保持 PWM=0；`1` 命令等待 3 秒后运行，`0` 立即停车，丢线搜索超时也会停车。

### 7.5 当前双编码器底层

- MOTOR1 编码器使用 PA25/PA14，MOTOR2 使用 PA26/PA27。
- PA26/PA27可以映射到硬件 TIMG8 正交编码器，但 PA25/PA14不能组成同一硬件正交通道。
- 为使两路计数口径一致，当前四根信号均采用 GPIO 双边沿中断和软件状态转移表解码。
- 当前为 A/B 两相四倍频有符号累计。
- 两路编码器已完成手动转动、正反转、每圈计数和闭环验证。
- 实车映射为左轮=MOTOR1(PA25/PA14)+TB6612 B，右轮=MOTOR2(PA26/PA27)+TB6612 A。
- 首次实测 MOTOR2 正交计数正常，向小车前进方向旋转时计数为负，反向为正。
- 旧映射下 MOTOR1 逐相诊断为监听PA24的通道始终为0、PA25持续产生边沿；交换电机后现象仍固定。重新核对原理图发现PA24本来就未作为MOTOR1编码器输入，实际信号是PA25/PA14，因此不能据此判定板卡故障。
- MOTOR2 逐相诊断结果为 A=4882、B=4881，两相匹配良好，软件正交解码正常。
- MOTOR1 软件解码使用 PA25/PA14，两相边沿和方向已验证。
- 速度层已按整车坐标统一反馈符号：左轮 MOTOR1 原始反馈乘 -1，右轮 MOTOR2 原始反馈乘 +1。
- 补充参考工程：`D:\robotmaster pj\RM PID\F401_PID 7.16\F401_PID-DIR\F401_PID-DIR` 是 STM32F401 + FreeRTOS + 四麦轮 + TB6612 的速度 PID 工程。可参考其100Hz采样、每轮独立PID、换向清积分和编码器转速换算结构。其编码器配置为11脉冲/电机轴转、四倍频、21.3:1减速比（理论937.2计数/输出轴转），与当前电机的11脉冲资料相符但减速比尚不能据此认定。工程中的STM32硬件层、麦轮运动学、Kp=35/Ki=10、单轮经验倍率及停止目标0.01均不得直接移植。
- 学长已同时提供该麦轮项目所用电机，必要时可将其作为当前 JGB680 的替换方案。若使用，应先确认实物型号、额定电压、减速比、额定/空载/堵转电流、输出转速、编码器定义、安装尺寸和输出轴规格；只有硬件条件一致后才可采用参考工程的21.3:1编码器参数，PID增益仍需重新整定。
- JGB680 十圈实测：MOTOR1 `-5252→19461`，每圈 `+2471.3`；MOTOR2 `386→-24371`，每圈 `-2475.7`，绝对值平均 `2473.5 count/rev`；正式程序按用户决定采用商家 `2450 count/rev`。

### 7.6 巡线基线与 CY-DXJ8 方案变更

- 历史已验收 YB-MVX05 接线：A0=PB25、A1=PB18、A2=PB21、OUT=PB22，黑线有效为高电平；该方案保留为回退基线。
- 2026-07-29 正式切换 CY-DXJ8：OUT1～OUT8=PB25、PB18、PB21、PB22、PA30、PB0、PB1、PB14，+5V 接载板5V，GND共地。
- CY-DXJ8 为八路并行输入，不再使用地址选择和5 us通道稳定等待。实物 `OUT8` 在最左、`OUT1` 在最右，软件反向排列为 `bit0=OUT8`、`bit7=OUT1`。
- 2026-07-29 实测 CY-DXJ8 白色地面输出低电平、黑线输出3.3 V高电平，可直接接MSPM0；左右方向已经确认。
- X1～X8 权重为 `-350,-250,-150,-50,50,150,250,350`。
- 基础循环 10 ms；速度 PI 周期 20 ms，KP=10、KI=1.0、KD=0，低通 `alpha=0.25`。
- 直线速度已由 55 RPM 提升并实车确认 70 RPM 稳定。2026-07-29 将普通弯基础速度改为 50 RPM；该新弯速已编译、尚待实车复测。
- 最外侧连续命中 20 ms 后进入急弯：2026-07-29 将外轮由 28 RPM 提高到 50 RPM，内轮保持 -12 RPM；中心稳定 30 ms 后退出。新参数尚待实车复测。
- 丢线后沿最后误差方向以外轮 22 RPM、内轮 -10 RPM 搜索 200 ms，超时停车。
- 用户已完成实车验证并确认巡线完美。

### 7.6.1 OLED 四键菜单实测

- 四个自备轻触开关接 H56-4～H56-1，依次为 UP=PB13、DOWN=PB23、OK=PB26、BACK=PB27。
- GPIO 使用内部上拉，实测松开为高电平 `1`、按下为低电平 `0`。
- `KEY TEST 0730` 诊断固件曾在 OLED 上直接显示四键原始电平，确认四路均能正确切换；随后关闭诊断模式，正式菜单可正常上下选择、确认和返回。
- PB26/PB27 与编码器 PA26/PA27 属于不同 GPIO 端口，不存在复用冲突。
- 当前有效工程路径为 `D:\ai embody\diansai start!\diansai-simulation`；同名旧工程不得作为后续编译与烧录来源。

### 7.7 角度环分支与当前 IMU 状态

- `Car_angle` 已实现三轴陀螺仪零偏校准、重力方向估计、倾斜安装角速度投影、Yaw 累计、角度 PID 和编码器里程计。
- 旧模块实测 `WHO_AM_I=0x70`，按 MPU6500 兼容器件工作。安装状态比例修正 1.268 后，手动 90°显示 89.7°；手动整圈累计 372.2°，需用可靠角度基准复标。
- 历史上曾将详细 IMU 日志限制到 UART1、让 HC-05 只保留短应答；2026-07-30 因反向乱码与连接不稳定正式放弃 HC-05 调试。
- 停车抗扰测试前后模块变为 `WHO_AM_I=FF`、陀螺仪全零，拆下后明显发烫，当前判定旧 IMU 已损坏并移除。
- 故障保护已完成：探测失败不校准、不启用角度保持，OLED 报错，避免无反馈驱动。
- 2026-07-27 已安装新的 MPU6050/GY-521 类模块；I2C地址为`0x68`，软件I2C使用`PA1=SCL`、`PA0=SDA`，INT接PB4但当前不依赖中断。驱动接受`WHO_AM_I=0x68/0x70`；新模块实际身份值尚未单独留档，旧模块的`0x70`不得作为新模块实测结论。
- 当前配置为陀螺仪±2000 dps、加速度计±2 g、DLPF约42 Hz、传感器采样125 Hz、控制更新约10 ms。菜单`CALIBRATE YAW`静止采集500点，标定三轴陀螺零偏和重力安装轴。
- Yaw统一符号约定（从车体上方俯视）：**逆时针为正，顺时针为负**。Angle Hold和后续控制均按此约定，不再额外反号。
- 新模块正式比例系数已标定为`1.172`；Angle Hold实测顺时针90°约`-90.7°`、逆时针90°约`+89.6°`，回到原朝向仅零点几度残差，比例、方向、回零和保持均通过实车验收。
- 灰度传感器也已更换；初测 `M00` 和不启动并非程序问题，而是 OUT 信号线漏接。补接 `OUT→PB22` 后巡线恢复正常。
- 新 MPU 的计时与比例问题已经修复并完成复测；当前 Angle Hold 已通过，不再保留“累计十余度、等待复测”为现行故障。

## 8. 当前后续方向

- 旧 YB-MVX05 的70 RPM成绩只作为历史性能参考；CY-DXJ8切换后从20 RPM重新验收，逐级提升到30/40/55 RPM，再决定是否恢复70 RPM。
- 新 MPU6050 的低风险上电、通信、角度标定和 Angle Hold 已完成；后续仅在功能集成后复核长期漂移与振动环境表现。
- 完成停车抗扰回正与行驶航向保持，并在灰度巡线中实现唯一方向路口的自动 90°转弯和重新捕线。
- 标定编码器里程换算，实现定距停车时同时保持航向。
- 持续观察高负载时 TB6612、电机和导线温升。

## 9. 仍未确定的信息

- 底盘实际轮距、轴距和模块位置；
- 比赛赛道和最终题目要求。

上述信息不影响当前基础巡线平台使用，待赛题或相关功能需要时补录。

## 10. 2026-07-30 当前可执行基线

| 项目 | 当前值 |
|---|---:|
| 左右轮速度 PID | Kp=12，Ki=1，Kd=0 |
| PID 输出限幅 | 9000 |
| 编码器与周期 | 2450 counts/rev，20 ms |
| 直线 / 普通弯 | 80 / 50 RPM |
| 急弯 | 外轮 50、内轮 -12 RPM |
| 丢线搜索 | 22 / -10 RPM |
| 正常启动延迟 | 3 s |

- 固件默认 PID 已更新为 `12/1/0`；历史串口 `GAINS`、`@PID` 和运行日志协议当前均不启用。
- `tools/pid_test/` 与 COM9 接法仅保留为历史工具资料，不适用于当前正式固件。
- 最新 HEX：`project/MSPM0G3507_Car/project/mdk/Objects/SeekFree_MSPM0G3507_Device_Library.hex`。

```powershell
.\tools\pid_test\.venv\Scripts\python.exe .\tools\pid_test\pid_test.py --port COM9 --baud 115200 --duration 12 --target 80
```

以上命令属于历史 PID 串口测试流程，当前正式固件不会响应。当前停止操作以本地 BACK 键和固件安全保护为准。
## 2026-07-30 完赛时间优化参数补充

- 菜单任务启动等待：0.5 s（50×10 ms）；PID 测试安全等待仍为 1 s。
- 直线：80 RPM；普通弯：65 RPM；急弯：50/-12 RPM；丢线搜索：22/-10 RPM。
- 状态统计：直线、普通弯、急弯、丢线分别累计毫秒数和进入次数，任务停止时从 UART3 PB2/PB3（COM9、115200）输出 `@LINESTAT,1`。
- 高频有线遥测为 `@PID,3`；HC-05/蓝牙保持弃用和断开状态。

### 极限速度试验档

- 直线 100 RPM；普通弯根据误差在 65～80 RPM 动态变化。
- 急弯 50/-12 RPM、丢线 22/-10 RPM；此档为极限测试参数，不作为稳定基线结论。

### 新电池高速与本地日志档

- PWM 输出限幅仍为 9000；直线 120 RPM，普通弯 75～90 RPM。
- MCU 使用 RAM 保存最近一圈 10 Hz 巡线日志，最终容量600条/60秒；新任务开始前清除。字段包含偏航角速度。
- 停车后通过 UART3 PB2/PB3 自动导出，也可用 `@PIDTEST,DUMP` 重传；没有使用 HC-05 或片内 Flash。

### 弯道控制融合结论

- 不使用“绝对角度环完全接管、灰度只在偏差大时接管”的硬切换方案，避免轮滑、轮距误差、IMU漂移和切换冲击。
- 规划采用曲率速度/偏航角速度前馈为主、IMU角速度阻尼、灰度连续低增益纠偏、丢线保护的融合结构。
- 当前先启用误差强度90/60的普通弯进入/退出迟滞，以及50 ms急弯确认和退出；待新日志取得 `yaw_rate_dps` 且轮距实测后再加入角速度前馈。

### 底盘几何实测

- 驱动轮距：209 mm。
- 灰度板预瞄距离：约219 mm。
- 八路探头相邻间距：10 mm，总跨度70 mm。
- 带载有效轮周长：195 mm（10圈1950 mm），有效轮径约62.07 mm。
- 标准半圆半径500 mm；内外轮轨迹半径395.5/604.5 mm，速度比约0.654。
- Angle Hold进入时相对角度归零，并使用带静止漂移补偿的完整IMU更新；IMU比例1.172及Angle Hold已验收通过。Yaw从车体上方俯视定义为逆时针正、顺时针负。

### IMU曲率融合当前参数

- 普通弯中心速度90 RPM，几何前馈内/外轮约71.2/108.8 RPM。
- 标准半圆目标偏航角速度幅值约33.5°/s；IMU角速度修正增益0.20 RPM/(°/s)，限幅±6 RPM。
- 正式顺时针任务的普通弯固定使用右转前馈，灰度连续低增益修正；急弯和丢线保持原独立安全状态机。
- RUNLOG v3记录实际与目标偏航角速度。

### 正式赛道状态机

- 正常巡线仅使用直线和标准500 mm半圆；旧急弯反转入口已关闭，丢线搜索保留为异常保护。
- 半圆连续80 ms确认后锁定，以IMU累计Yaw作为弧段进度；达到160°并连续50 ms重新居中后退出。
- 正常目标斜坡限制4 RPM/10 ms，降低直线与圆弧轮速切换冲击。
- LINE ONLY/BALL VISION首次启动时若IMU未校准会自动静止校准，校准失败则拒绝启动。
- 圆弧识别在运动开始后前0.5秒禁用，并只接受连续成片的灰度掩码，避免A点启停横线触发固定右转前馈。

> 2026-07-30更正：用户在启停线后释放，横向灰度误差无法区分直线偏移和真实圆弧。基于误差的自动圆弧融合已关闭；当前安全版本使用灰度连续纠偏且不启用急弯反转。后续改用里程阶段识别。

### 启停线停车规则

- 从启停线前方少量距离释放；第一次至少5路连续30 ms命中横线时只标记起点并清零里程。
- 行驶里程达到550 cm后，第二次相同图样触发立即停车；BACK本地急停始终有效。

### 2026-07-30 19:40 当前正式测试档（覆盖上方旧参数）

- 菜单模式名仍为 `LINE ONLY`；不使用蓝牙。
- 速度PID `12/1/0`，PWM限幅9000；直线目标120 RPM，灰度误差弯速75～90 RPM。
- 固定圆弧/IMU融合关闭，旧急弯反转关闭；丢线搜索22/-10 RPM。
- 普通巡线目标加速最大4 RPM/10 ms、减速最大2 RPM/10 ms。
- 速度目标下降时，每下降1 RPM释放8 PWM，并限制单次释放不超过80 PWM；不再按新旧目标比例缩放PI存量输出。
- 启停线当前规则改为至少4路连续20 ms；首次清零里程，550 cm后第二次停车。三路图样在普通弯中会出现，暂不可用于横线确认。
- RAM日志10 Hz、600条/60 s；UART3 PB2/PB3、115200，常用COM9；停车后可DUMP重传。
- `run_20260730_192755.csv` 相较上一圈将丢线由66条降至1条，但当时比例释放造成直线实际约80 RPM；当前有界释放版本等待实车复测。
- 最新HEX：`project/MSPM0G3507_Car/project/mdk/Objects/SeekFree_MSPM0G3507_Device_Library.hex`；构建Code=51648、RO=3620、RW=224、ZI=22832，0 error、0 warning。

### 2026-07-30 23:36 正式满载稳定档（覆盖上方19:40参数）

- 满负载实车已完成整圈，约18.0 s检测到终点宽线，巡线阶段进入20 s。
- 直线目标160 RPM；普通弯基础速度92～115 RPM；巡线KP=0.20、KD=0.20，最大纠偏75 RPM。
- 自动固定圆弧/IMU曲率融合保持关闭；正常循迹继续使用灰度连续PD。
- 普通目标加速4 RPM/10 ms、减速10 RPM/10 ms；单步目标下降达到8 RPM时按8 PWM/RPM释放PI输出，单次最多160 PWM。
- 丢线先确认50 ms，再以55/20 RPM双轮正转差速搜索300 ms；仍未捕线才允许35/-20 RPM反转搜索。
- 终点横线要求至少4路有效且同时覆盖灰度板左右半区；第二次确认后执行倒车寻线和IMU回正。
- `run_20260730_233651.csv`共219条，无`mask=0`、无丢线搜索，用户确认满载表现完美。
- 最新HEX：`project/MSPM0G3507_Car/project/mdk/Objects/SeekFree_MSPM0G3507_Device_Library.hex`；构建Code=53596、RO=3728、RW=224、ZI=22848，0 error、0 warning。
