liuba688/diansai-simulation/开发历程合并时间线.md

# 终版小车开发历程合并时间线

> 更新日期：2026-07-29  
> 本文按日期合并本人分支和队友分支的开发记录。历史工作即使后来被取消也不删除，
> 只标注最终结论。详细排错见《调试日志.md》，完整资料见《终版小车信息总档案.md》。

## 2026-07-23｜工具链与底层

### 本人

- 完成 Keil/Arm Compiler 6、CMSIS-DAP、LED、UART、蜂鸣器和 OLED 的实机验证。
- 完成 MPU-6500 兼容芯片识别、零偏校准、TB6612 底层和双编码器四倍频解码。
- 纠正 MOTOR1 编码器引脚为 PA25/PA14。
- 电机十圈标定平均约 2473.5 count/rev；正式闭环采用 2450 count/rev。

### 队友

- 使用相同底盘、引脚和工程基线，无相互冲突的独立修改。

## 2026-07-24｜参考工程与硬件资料

### 本人

- 完成学长车速度 PID 工程预验证，确认控制结构可参考，硬件层和参数不能直接照搬。
- 补录 JGB680/MG680 电机规格、减速比、编码器口径、电流和转矩单位。
- 归档 PCB、Gerber、UART、TB6612、编码器和供电接线资料。
- 决定切换到自己的双轮底盘和电机继续闭环测试。

### 队友

- 沿用上述底盘与接线资料，没有覆盖这一天的验证记录。

## 2026-07-25｜速度闭环与蓝牙阶段验证

### 本人

- 完成左右轮、驱动通道和编码器反馈符号校正。
- 完成 20/30/60/100 RPM 架空测试；30 RPM 误差约 1%，最高 duty 不到 6000。
- 当时完成 HC-05 PB2/PB3 双向通信和 `1/0` 启停实测。
- 蓝牙工作作为真实历程保留；7 月 29 日融合版本已删除蓝牙业务功能。

### 队友

- 继承速度闭环和当时的启停基线，没有改变速度 PI 核心参数。

## 2026-07-26｜灰度巡线、角度环与里程计

### 本人

- 接入 YB-MVX05，完成地址扫描、八路位图和加权位置误差。
- 完成动态弯道降速、外轮限速、急弯状态机和沿最后方向搜索 200 ms 的丢线恢复。
- 完成实车巡线验收；70 RPM 直线速度通过当时实测。
- 加入 MPU6050/MPU6500 角度累计、角度 PID、静止角度保持和编码器里程计。
- 倾斜安装采用三轴投影；旧模块比例 1.268 下手转 90°显示 89.7°，整圈 372.2°。
- 修复长 IMU 日志导致的串口不稳定，详细遥测转到 UART1。
- 旧 IMU 后来出现 `WHO_AM_I=FF`、全零并发热，停止使用并加入故障保护。

### 队友

- 保持本人形成的巡线、速度闭环、角度测量和里程计基础。

## 2026-07-27｜传感器恢复与视觉寻球

### 本人

- 更换灰度传感器和 MPU6050，将角度环源代码合入主线。
- OLED 一直显示 `M00` 最终定位为灰度 OUT 漏接；补接 `OUT→PB22` 后巡线恢复。
- MPU 驱动同时接受 `WHO_AM_I=0x68/0x70`；新模块比例恢复 1.000，等待重新标定。
- 记录新 MPU 多次角度保持后的累计误差，以及 TIM_G12 16 位回绕风险。

### 队友

- 新增 MaixCAM `steel_ball_320_v2`，完成多帧跟踪、控制确认、30 Hz 目标帧和
  5 Hz 小车状态回传。
- 新增 MSPM0 视觉运动状态机、CRC8 UART2 协议、轨迹倒放和灰度重新捕线。
- 完成红框预警减速、绿框稳定确认和目标接近流程。
- 当时曾实现 PB10 电磁铁、吸取保持和定时释放。该过程保留；7 月 29 日按最终决定
  删除了驱动、负载字段和吸取/释放逻辑。
- 当时完成 CCS 全量构建、Python 协议/跟踪测试和纯 C 状态机测试。

## 2026-07-28｜赛前排错与取舍

### 本人

- 继续诊断 HC-05 单向乱码和上电自检阻塞，确认蓝牙不作为正式比赛链路。
- 继续记录新 MPU 运动累计误差与定时器回绕问题，等待实机复测。

### 队友

- 视觉寻球代码维持 7 月 27 日状态，等待与底盘联合整合。

## 2026-07-29｜正式赛题与双分支融合

### 本人赛题工作

- H 题发布后整理指标、三人分工和当天计划。
- 冻结 YB-MVX05 正式巡线方案，取消效果不佳的 CY-DXJ8。
- 审计 PCB 接线，补录四键、摆杆执行器、摄像头串口和图传供电约束。
- 保留往年题库、2024 复现工程和 2026 H 题资料。

### 融合结果

- 合并队友仓库与本人仓库的 Git 历史。
- 巡线、MPU6050 角度环、静止角度保持、里程计、菜单和速度 PID 使用本人版本。
- 完整保留队友的钢球识别、跟踪、UART2 协议、视觉状态机、轨迹倒放和重新捕线。
- 删除电磁铁驱动及吸取/释放逻辑；删除 HC-05 测试工程和蓝牙业务控制。
- OLED 菜单统一提供视觉识球、角度保持、纯巡线、航向校准和里程计查看。
- Keil 和 CCS 工程均保留并补齐融合源文件。
- Python 7 项测试、纯 C 状态机测试通过；Keil 全量构建 0 error、0 warning；
  CCS XML 校验通过，本机没有 CCS 编译器，因此本次未重新编译 CCS。
- 提交并推送 `2b1da85`，备注为“7.29开赛汇总”。

### 当日晚间实机联调

- 四个自备轻触开关最终使用 H56-4～1：PB13/PB23/PB26/PB27，对应 UP/DOWN/OK/BACK。
- 通过 OLED `KEY TEST 0730` 诊断页确认四键松开=1、按下=0，正式菜单随后恢复并可正常操作。
- 排查出两个工作区存在同名 Keil 工程；正式开发和烧录路径统一为 `D:\ai embody\diansai start!\diansai-simulation`。
- 直线速度保持已验收的 70 RPM；普通弯基础速度与急弯外轮目标提高到 50 RPM，编译通过，等待实车巡线验收。

## 今后的记录规则

- 不再用当前状态摘要覆盖开发日志或总档案。
- 失败、取消和被删除的方案仍保留，并标明取消日期与原因。
- 每天的硬件结论、代码改动、实机测试、排错和决策按日期追加。
- 本人与队友的工作分别记录，确保融合后仍能追溯来源。

## 2026-07-30｜巡线满载进入20秒

- 从70 RPM稳定档逐步提升到直线160 RPM、普通弯92～115 RPM，并保留灰度连续PD与分级丢线恢复。
- 修复高速入弯时速度PI存量输出卸载滞后，最终采用10 RPM/10 ms减速斜率及8 RPM大幅释放门槛。
- 完成起终点宽线跨区判定，以及第二次终点检测后的倒车寻线和IMU回正。
- `run_20260730_233651.csv`满负载整圈无`mask=0`、无丢线搜索，约18.0 s检测终点，用户确认完美完成任务。
- 最新Keil固件构建0 error、0 warning，当前版本冻结为视觉模块与步进电机搭载前的正式巡线基线。
