liuba688/diansai-simulation/docs/当前开发交接_2026-07-30.md

# 当前开发交接（2026-07-30 19:40）

## 一句话状态

当前稳定方案为 `LINE ONLY`：直线目标120 RPM，灰度误差自适应弯速75～90 RPM，输出限幅9000，旧急弯反转和基于灰度误差触发的固定圆弧/IMU前馈均关闭。最近一圈丢线已由66个100 ms采样点降到1个，但上一版PI输出释放过强导致直线实际速度只有约80 RPM；最新固件已改为缓和减速和有限PWM释放，等待下一圈验证。

## 新对话必须先读

1. 本文件。
2. `开发进度.md`。
3. `终版小车信息总档案.md`。
4. `调试日志.md`。

历史章节中若与本文件冲突，以本文件和各文档末尾的“当前版本”章节为准。

## 当前硬件与连接

- MCU：MSPM0G3507。
- PID/日志串口：UART3 PB2/PB3，载板插座标UART4；USB-TTL通常为COM9、115200。
- TTL TX → 板RX，TTL RX → 板TX，GND共地，不接VCC；COM17不是PID口。
- 不使用蓝牙。
- 新电池约12.5 V；旧电池已降至10.8 V。
- 左右驱动轮距209 mm；灰度板预瞄218～220 mm，代码按219 mm。
- 8路灰度相邻10 mm，总跨度70 mm。
- 带载滚动10圈1950 mm：有效轮周长195 mm、有效轮径约62.07 mm。
- 编码器2450 counts/rev；速度环周期20 ms，主控制周期10 ms。
- MPU6050比例1.172已实车验收；逆时针Yaw为正、顺时针为负。

## 当前固件参数

- 菜单巡线模式仍名为 `LINE ONLY`。
- 启动延迟0.5 s。
- 速度PID：Kp=12、Ki=1、Kd=0。
- PWM输出限幅：9000。
- 直线目标：120 RPM。
- 灰度误差弯速：75～90 RPM。
- 丢线搜索：外轮35 RPM、内轮-20 RPM；30个10 ms周期后仍丢线则停止。
- 旧急弯入口关闭：`LINE_FOLLOW_SHARP_ENABLE=0`。
- 固定圆弧/IMU融合关闭：`LINE_FOLLOW_ARC_FUSION_ENABLE=0`。原因是横向灰度误差不能区分直线偏移与真实圆弧入口。
- 普通巡线目标：加速最大4 RPM/10 ms，减速最大6 RPM/10 ms。
- 速度目标下降时不再按比例反复削减PI输出；当前改为每下降1 RPM释放4 PWM，单次最多释放40 PWM。

## 启停线规则

- 小车从5 cm启停线前少量距离释放。
- 至少4路灰度同时有效、连续20 ms确认横线。
- 第一次确认只标记起点并清零里程，不停车。
- 起点后里程不足550 cm时禁止终点触发。
- 第二次确认立即停车，然后导出状态摘要与RUNLOG。
- 最近 `run_20260730_192755.csv` 只在起步处出现一次6路命中，后程没有任何4路及以上命中；因此终点未识别不是门槛仍太高，而是灰度日志中没有再次扫到横线。暂时不要降为3路，普通弯中存在多次3路图样，可能误停。

## 本地日志

- MCU RAM按10 Hz保存巡线日志，容量600条、最长60 s；断电或开始新巡线会清除。
- 字段：时间、左右目标/实际RPM、左右PWM、灰度mask/error、巡线状态、实际/目标偏航角速度。
- 停车后自动发送；电脑未监听时，重新连接USB-TTL后可发送DUMP重读。
- PowerShell下载：

```powershell
cd 'D:\ai embody\diansai start!\diansai-simulation'
py .\tools\pid_test\download_run_log.py --port COM9
```

若项目虚拟环境确实存在，也可使用：

```powershell
.\tools\pid_test\.venv\Scripts\python.exe .\tools\pid_test\download_run_log.py --port COM9
```

## 最近两圈结论

### `run_20260730_181153.csv`

- 317条、100 ms周期。
- 丢线状态66条。
- 入弯时目标已从120降至约90/64.5 RPM，但实际仍约127.7/125.3 RPM，直线阶段积累的增量式PI输出未及时释放，导致冲入弯道。
- 仅出现一次5路宽线命中，旧的5路/30 ms条件没有完成可靠确认。

### `run_20260730_192755.csv`

- 251条、100 ms周期，有效运动约24.7 s。
- 丢线仅1条，稳定性相较上一圈显著改善。
- 入弯跟随改善：目标90/66.5时实际约75.5/62.9 RPM。
- 但直线居中且目标120/120时，实际平均仅约81.9/79.3 RPM；输出峰值仅约5067/5063，远未达到9000。
- 根因是当时使用“按目标比例释放PI输出”，灰度误差频繁变化时不断削弱已积累PWM，造成直线慢和卡顿。
- 最新固件已经用有限PWM释放替代比例释放，但尚未取得实车日志。

## 下一圈测试要求

烧录最新HEX后跑一圈，同时给出从小车开始运动计时的大致节点，误差±0.5 s即可：

- 第一段直线开始与结束。
- 开始入弯。
- 完全进入圆弧。
- 开始出弯。
- 完全回到直线。
- 每一次卡顿、提前减速、突然转向或丢线的时间。
- 是否识别起点横线、是否在终点自动停车。

这些时间点用于把mask、误差、轮速和IMU角速度对齐，提取真正的直线/圆弧特征。最终不建议采用固定时间脚本，因为电池、释放点和轮滑都会改变到达时刻；应增加持续确认、迟滞和状态锁定。

## 新对话下一步

1. 先验证最新“减速2 RPM/10 ms + 有限PWM释放”是否消除直线卡顿，并使直线实际速度重新接近120 RPM。
2. 对齐用户标注的直线/入弯/出弯时间与日志，建立可靠的直线/标准圆弧状态判定。
3. 状态识别应融合连续灰度图样、持续时间、IMU角速度和里程阶段；不要再仅以横向误差触发固定右转。
4. 状态识别可靠后，再考虑重新启用标准500 mm圆弧的几何轮速前馈和IMU角速度阻尼。
5. 继续检查终点横线是否被物理扫到；在没有4路宽线证据前不要降到3路。

## 20:31日志诊断与20:38安全修复

- `run_20260730_203124.csv` 暴露出测试固件与19:40交接基线不一致：日志在51.0～56.6 s持续为圆弧状态，且目标偏航角速度为33.5°/s，确认当时烧录版本实际启用了固定圆弧融合。
- 圆弧期间灰度误差已由正跨到负并达到-350，但目标仍长期约102～120/60～78 RPM，固定右转轮速差压过灰度小增益修正；56.8 s首次出现`mask=0`，之后的35/-20 RPM是丢线搜索结果，不是最初原因。
- 当前源码已将`LINE_FOLLOW_ARC_FUSION_ENABLE`恢复为0，下一圈先按纯灰度巡线验证，不再由里程状态强制制造圆弧轮速差。
- 为将来重新启用融合预留保护：固定转向期间若连续50 ms出现反方向且绝对值不小于150的灰度误差，则锁止本里程弯段的圆弧前馈，立即交还普通灰度巡线；离开该弯段后才清除锁止。
- 本次未提高普通巡线KP/KD，避免用更强摆动掩盖状态机错误。

## 20:52日志诊断与20:59瞬时丢线修复

- `run_20260730_205241.csv`共241条，全部记录为普通巡线状态，`yaw_rate_target_dps`全0，确认固定圆弧融合已经关闭；10 Hz记录中没有持续`mask=0`。
- 用户秒表边界为运动后约6.14、11.97、18.95、26.60 s；日志只覆盖到约23.60 s，未包含第二次完整出弯。
- 两个已覆盖边界附近，目标轮速已经恢复相等而右轮实际速度明显滞后：6.14 s附近约108/108目标、84/57实际；11.97 s附近约120/120目标、91/76实际。
- 17.7 s出现39/-16 RPM目标，符合一次低于100 ms、被10 Hz日志漏掉的丢线搜索后首个恢复周期，说明原策略会把单次灰度漏检立即放大为内轮反转。
- 新版增加30 ms丢线确认：确认期间维持最后转向趋势并降至外/内轮60/45 RPM，不反转；确认后才进入35/-20 RPM搜索。
- 从搜索重新捕线时，负转速轮的正向恢复斜率临时由4提高到12 RPM/10 ms，缩短反转残留。
- `@LINESTAT`新增`loss_events`，按10 ms控制层统计每一次无效灰度事件，避免被10 Hz RUNLOG漏记。
- 为改善直线实际速度，PI减速释放由8 PWM/RPM、单次80 PWM减半为4 PWM/RPM、单次40 PWM；入弯目标减速斜率仍保持6 RPM/10 ms。

## 21:13日志诊断与21:15第一阶段提速

- `run_20260730_211330.csv`共230条，运动日志约22.5 s；全部记录为普通巡线状态，无反转目标。仅22.2 s出现一次`mask=0`，30 ms确认策略将目标保持在69/29 RPM并成功避免35/-20 RPM反转，说明瞬时丢线保护生效。
- 用户反馈仅第二次入弯前卡顿。日志显示约15.2～15.4 s灰度仍为`mask=24/error=0`，目标却从约119/119降到94/94；根因是圆弧融合关闭后，按里程提前刹车代码仍独立运行。
- 按里程提前刹车现已与`LINE_FOLLOW_ARC_FUSION_ENABLE`绑定；融合关闭时纯灰度巡线不再受隐藏里程限速干预。
- 第一阶段提速：直线目标由120提高到130 RPM，普通弯基础速度范围由75～90提高到82～100 RPM；灰度纠偏增益、最大修正、丢线确认和搜索参数不变。
- 本轮只提高约8%～11%，先验证实际轮速跟随、第二次入弯卡顿是否消失及瞬时丢线次数，再决定是否继续升至140/105～110 RPM。

## 21:22终点倒车寻线与IMU回正

- 第二次确认基准线后不再立即结束任务，新增低速停车对齐状态机。
- 先制动200 ms；若制动后灰度板已经越过横线，则以约-18 RPM倒车重新寻找横线；若制动后仍压在线上，则先倒车离开，再以约12 RPM前进回到横线。
- 寻线过程中叠加以本圈0°为目标的IMU航向修正，差速修正限幅8 RPM。
- 重新检测到至少4路宽线后进入原地微调；必须同时满足宽线有效、Yaw绝对误差不超过1.5°并连续50 ms，才输出`@FINISH,2,ALIGNED`并停车、导出日志。
- 对齐总过程设置约3 s和15 cm双重安全上限；超限时输出`@FINISH,2,ALIGN_TIMEOUT`并停车，不允许持续倒车。BACK与串口STOP仍可立即中断。

## 21:34日志诊断与21:44压边保护

- `run_20260730_213457.csv`仍是旧120/75～90 RPM目标：全圈最高目标120 RPM、最小弯速75 RPM，未验证21:15生成的130/82～100 RPM提速档。烧录下一版后应先通过日志最高目标确认版本。
- 该圈无持续丢线，但`mask=128`共11个100 ms采样；第二弯约19.1～19.7 s连续约0.7 s只剩最外侧探头，安全余量不足。
- 新版保留直线130 RPM、普通弯82～100 RPM，同时增加分级压边救车：`mask=1/128`出现时立即把纠偏提升到70 RPM上限，优先将黑线拉回灰度板内部。
- 仅当最外侧单探头连续达到200 ms时，基础速度才临时降至75 RPM；离开最外侧后解除保护并恢复正常弯速，避免正常弯道长期降速。
- `@LINESTAT`新增`edge_events`和`edge_max_ms`，分别记录压边段次数及最长连续压边时间；目标是后续将`edge_max_ms`压到200 ms以内。

## 21:54日志复核与22:03平滑140 RPM档

- `run_20260730_215413.csv`确认130 RPM版本已生效，运动后约21.7 s触发终点对齐；直线目标130时实际平均约98.1/92.4 RPM。
- 该圈有两次`mask=0`，其中一次进入35/-20 RPM反转搜索；搜索与最外侧强制70 RPM纠偏造成实际轮速差超过60 RPM及偏航角速度瞬时约-61°/s。结合219 mm灰度预瞄距离，最外侧探头命中本身不等价于车轮即将越线，强制阶跃反而可能扩大扰动。
- 新版直线目标由130提高到140 RPM，普通弯仍保持82～100 RPM，不同时提高弯速。
- 取消`mask=1/128`时强制70 RPM纠偏和连续200 ms降至75 RPM；恢复原连续PD，误差350时自然修正约63 RPM，`edge_events/edge_max_ms`仅保留为诊断。
- 瞬时丢线确认由30 ms延长到50 ms。确认后先以外/内轮55/20 RPM双轮正转差速搜索150 ms；仍找不到线才进入35/-20 RPM反转搜索，降低轮速突变。

## 22:14日志诊断与22:22高速160/115 RPM档

- `run_20260730_221447.csv`确认140 RPM直道目标生效，居中实际平均约101.5/98.3 RPM，直道表现改善；第二弯仍发生持续丢线。
- 入弯时目标已由约100/82降至86/44甚至82/19 RPM，但右轮实际仍高达91、64 RPM，说明丢线主因是大幅目标下降时PI输出卸载不足，而非直道目标本身或最外侧探头纠偏过弱。
- 新版直线目标提高到160 RPM，普通弯提高到92～115 RPM；巡线KP由0.18提高到0.20、修正限幅由70提高到75 RPM，使弯速提高后仍保留足够轮速差。
- PI输出释放改为分级：小于15 RPM的目标下降仍为4 PWM/RPM、单次最多40 PWM；达到15 RPM的大幅入弯下降改为8 PWM/RPM、单次最多160 PWM，只强化真正的入弯减速，不反复削弱直线积累。
- 终点误触发修复：横线除至少4路有效外，还必须同时覆盖灰度板左半区`0x0F`和右半区`0xF0`。上一圈弯道中的`mask=240`只在右半区，不再触发终点倒车；倒车重新寻线的完成判定同样采用跨区宽线。

## 23:21满载日志诊断与23:25高速入弯制动修复

- `run_20260730_232122.csv`为满载测试，直线160目标时实际平均约131.2/128.7 RPM，入弯前瞬时约150.5/145.0 RPM；实际速度高于上一圈空载记录，第一弯发生持续丢线并在6.4 s停止。
- 目标已降至109/75甚至97/27 RPM时，实际仍约150/145、130/121 RPM，确认根因是高速入弯执行滞后，不是满载导致直线动力不足。
- 原大幅PI释放门槛为单次下降15 RPM，但目标减速斜率每10 ms最多6 RPM，导致大幅释放分支基本无法触发。
- 当前保持直线160、弯道92～115 RPM不变；目标减速斜率由6提高到10 RPM/10 ms，大幅PI释放门槛由15降到8 RPM。每个高速入弯减速步使用8 PWM/RPM、单次最多160 PWM，普通小幅变化仍用4 PWM/RPM、单次最多40 PWM。
- 丢线后的55/20 RPM双轮正转搜索由150 ms延长至300 ms；持续300 ms仍无黑线才允许35/-20 RPM反转，避免满载惯性尚未消除就产生80 RPM以上轮速差。

## 23:36满载稳定基线验收

- `run_20260730_233651.csv`完成满负载整圈任务，用户确认实车表现完美。
- 219条日志全部为普通巡线状态，`mask=0`为0，未触发正转或反转丢线搜索；说明“减速10 RPM/10 ms + 8 RPM大幅释放门槛 + 分级PI卸载”解决了满载高速入弯滞后。
- 直线目标160 RPM时实际平均约122.9/121.0 RPM；约18.0 s检测到终点宽线并进入停车对齐阶段，满载赛道行驶已进入20秒以内。
- 日志18.1 s之后的负轮速及小幅正反转属于终点倒车寻线/IMU微调，不计入赛道巡线丢线或行驶时间。
- 当前正式满载稳定速度档：直线160 RPM、普通弯92～115 RPM、KP=0.20、最大连续纠偏75 RPM；在视觉与步进电机完整载荷下已通过一圈验收。后续优先做重复性测试，不再立即提速。

## 最新构建

- HEX：`project/MSPM0G3507_Car/project/mdk/Objects/SeekFree_MSPM0G3507_Device_Library.hex`
- 最新构建时间：2026-07-30 23:25。
- Keil结果：Code=53596、RO-data=3728、RW-data=224、ZI-data=22848，0 error、0 warning。

测试必须保留安全区域、本地BACK急停和物理断电手段。
