liuba688/diansai-simulation/before the final car/PID速度闭环测试说明.md

# 学长车 PID 速度闭环测试

## 工程入口

`MSPM0G3507_Car/project/mdk/SeekFree_MSPM0G3507_Device_Library.uvprojx`

本目录是正式工程的完整副本。正式工程未修改；本副本的 TB6612 输出已开启。

## 已采用的学长车参数

- 编码器：11 PPR
- 解码：AB 四倍频
- 减速比：21.3:1
- 输出轴计数：937.2 count/rev
- 基础调度周期：10 ms
- 速度统计与控制窗口：50 ms（20 Hz）
- 增量式 PID：Kp=25、Ki=1、Kd=0
- 转速一阶低通系数：0.35
- 测试输出限幅：±3000（30% PWM）

## 自动测试时序

完成约 4 秒 IMU 静止校准并短鸣一次后，程序循环执行：

1. 停车 3 秒；
2. +30 RPM 运行 6 秒；
3. 停车 3 秒；
4. -30 RPM 运行 6 秒。

PB16 每 500 ms 翻转。UART1（PB6 TX，115200）每 500 ms 输出一次目标转速、
滤波后实测转速乘 100、PWM 和 50 ms 编码器增量。

## 首次实测

1. 必须将两个驱动轮架空，确认周围无线缆和物体。
2. 首次只短时上电，手放在电源开关旁。
3. 蜂鸣器短鸣后仍有 3 秒停车时间；观察随后两轮是否平稳启动。
4. 若任一路 PWM 很快到 `3000`，但该路 `rpm_x100` 为负或持续接近 0，立即断电。
   这表示该路编码器符号或接线不匹配，禁止继续闭环测试。
5. 正常时，`target=30` 对应 `rpm_x100` 应逐渐接近 `3000`；
   `target=-30` 对应 `rpm_x100` 应逐渐接近 `-3000`。

## 第一轮实测结论

- 10 ms 测速窗口内每次只有约 12～13 个计数，单个计数对应约 6.4 RPM，
  日志出现约 ±77～83 RPM 的大步进。
- 原 35/10 增益在当前直接 RPM 单位下使 PWM 持续在 ±3000 饱和翻转。
- 相同 PWM 符号下，MOTOR1 与 MOTOR2 的编码器原始计数方向相反。
- 第二版据此改为 50 ms 窗口、低通测速、25/1 保守增益，并分别修正编码器符号。

## 保留功能

- PA7 低电平触发蜂鸣器：IMU 校准完成后短鸣 200 ms；
- MPU-6500 上电校准及每秒日志；
- OLED 状态显示；
- PB16 心跳；
- 双编码器正交解码。
