liuba688/diansai-simulation/2024赛题复现/开发进度.md

# 2024 H 题要求（4）开发进度

更新日期：2026-07-26  
当前阶段：固件已编译，等待实车测试

## 目标

完成要求（4）：按要求（3）的 A → C → B → D → A 路径连续运行 4 圈，并在第 4 圈回到 A 后停车。当前因 MPU 损坏，不使用角度闭环；不实现声光提醒。

## 已完成

- 从更新后的 `Car_line` 建立独立工程 `2024赛题复现/MSPM0G3507_Car`。
- 根据实车反馈，将巡线回退为根目录 `project` 中的更新前版本：
  - 八路数字灰度单次采样；
  - 直接计算加权位置误差；
  - 不使用三帧多数滤波；
  - 不使用连续黑块筛选和置信度；
  - 不使用误差、微分低通。
- 实现第一圈路线：
  - A → C：白场直行找黑线；
  - C → B：沿弧线巡线；
  - B 点：定时差速转向；
  - B → D：白场持续直行找黑线；
  - D → A：沿弧线巡线。
- 实现第四题四圈循环：
  - 第 1～3 圈到达 A 后进行镜像差速转向；
  - 转向完成后重新直行寻找 C；
  - 第 4 圈到达 A 后停车。
- 丢线策略改为先低速直行前探约 150 ms，仍未找到黑线才确认线端。
- 保留蓝牙 `1`/`START` 启动、`0`/`STOP` 急停和 3 秒安全延时。
- 更新 OLED、UART 状态输出，UART 增加已完成圈数 `lap`。
- Keil Arm Compiler 6.24 编译通过：0 Error、0 Warning。

## 当前参数

| 功能 | 参数 | 当前值 |
|---|---|---:|
| 巡线直线速度 | `LINE_FOLLOW_STRAIGHT_RPM` | 80 RPM |
| 巡线弯道最低速度 | `LINE_FOLLOW_MIN_CURVE_RPM` | 40 RPM |
| 急弯外轮 | `LINE_FOLLOW_SHARP_OUTER_RPM` | 38 RPM |
| 急弯内轮 | `LINE_FOLLOW_SHARP_INNER_RPM` | -12 RPM |
| 丢线前探速度 | `LINE_FOLLOW_LOST_FORWARD_RPM` | 32 RPM |
| 丢线前探时间 | `LINE_FOLLOW_LOST_FORWARD_TICKS` | 15 × 10 ms |
| A→C、B→D 直行速度 | `ROUTE_SEARCH_RPM` | 55 RPM |
| B 点左轮 | `ROUTE_TURN_LEFT_RPM` | 28 RPM |
| B 点右轮 | `ROUTE_TURN_RIGHT_RPM` | 82 RPM |
| A 点左轮 | 镜像设置 | 82 RPM |
| A 点右轮 | 镜像设置 | 28 RPM |
| A/B 转向时间 | `ROUTE_TURN_TICKS` | 100 × 10 ms |
| 找到黑线确认 | `ROUTE_LINE_CONFIRM_TICKS` | 5 × 10 ms |
| 线端确认 | `ROUTE_LOST_CONFIRM_TICKS` | 15 × 10 ms |
| 总圈数 | `ROUTE_TOTAL_LAPS` | 4 |

## 尚未实测

截至 2026-07-26 晚，当前四圈版本没有进行实车测试。下面各项均不能仅凭编译结果确认：

- B 点左转角度是否足够且不会过量；
- A 点镜像右转能否对准下一圈的 C；
- 55 RPM 白场直行是否有明显左右偏航；
- 80 RPM 巡弧线是否会冲出黑线；
- 150 ms 丢线前探是否造成端点过冲；
- 圈数是否准确累计到 4；
- 第 4 圈是否在 A 点可靠停车；
- 电量变化是否影响定时差速转角。

## 下一步

优先按《调试日志》中的测试顺序进行。不要直接从完整四圈高速测试开始；先架空确认轮向，再分别验证单个 B 点转向、单个 A 点转向，最后进行 1 圈和 4 圈测试。
