liuba688/diansai-simulation/docs/completion_audit.md

# 7.29 融合完成审计

## 已融合

- MaixCAM 模型、跟踪器、UART2 协议和测试保留。
- MSPM0 视觉接近、轨迹记录/倒放与重新捕线保留。
- 灰度巡线采用实车版本：丢线按最后方向搜索 200 ms 后停车。
- MPU6050/6500、角度 PID、静止保持、里程计和速度 PID 使用本地版本。
- OLED 四键菜单成为唯一用户控制入口。
- 电磁铁驱动、相关状态字段和状态回传标志已删除。
- HC-05/UART3 蓝牙命令与说明已删除。
- Keil 与 CCS 工程均登记全部融合模块。
- 往年题库、今年题目和参考资料保留。

## 验证要求

- Python 视觉/协议测试：7 项通过。
- C 主机状态机与巡线测试：通过。
- Keil ArmClang 全量构建：0 errors、0 warnings。
- Keil 输出：Code 39876、RO-data 2848、RW-data 224、ZI-data 8128。
- Keil 与 CCS 工程 XML：解析通过。
- 当前机器未安装 CCS 编译器，因此 CCS 目标未在本机实际链接。

实车仍需复核按键顺序、视觉左右转向符号、IMU 安装方向和速度参数。
