liuba688/diansai-simulation/vision/training/analysis/focus_shift_report.md

# 钢珠模型焦点域偏移诊断报告

## 技术摘要

当前 `steel_ball_320_v2` 在轻微失焦时优于清晰对焦，最可能的主因是训练数据与部署画面的焦点状态不一致，而不是“模糊图像天然更适合识别”。

第二版训练集共有 3,548 个钢珠框，其中 `scene_0011`、`scene_0013`、`scene_0015` 合计贡献 2,304 个，占 64.9%。对这些场景的代表性钢珠裁剪进行可视化检查后，可以看到轮廓和高光普遍偏软。模型因此可能主要学习了模糊轮廓、扩散高光和低频灰度结构；镜头重新清晰对焦后，边缘、高光形状和局部纹理发生变化，导致置信度与召回率下降。

最终方案不应长期故意失焦。建议先按比赛实际工作距离清晰对焦并锁定镜头，再补充以清晰样本为主、少量轻微前后偏焦样本为辅的数据，清理错误标注后重新训练并转换 MaixCAM 模型。

## 主要发现与证据

### 1. 新增场景主导了第二版训练数据

| 场景 | 数据划分 | 钢珠框数 | 框宽中位数（像素） | Laplacian 中位数 |
|---|---|---:|---:|---:|
| `scene_0004` | train | 100 | 57.5 | 949.41 |
| `scene_0009` | train | 1,144 | 33.0 | 657.93 |
| `scene_0011` | train | 1,037 | 27.0 | 438.00 |
| `scene_0013` | train | 13 | 41.0 | 407.05 |
| `scene_0015` | train | 1,254 | 23.0 | 657.86 |
| `scene_0007` | val | 438 | 26.0 | 731.82 |

`scene_0011`、`scene_0013`、`scene_0015` 合计占训练框的 64.9%，因此这些场景的成像状态会明显影响第二版模型。

### 2. 代表性裁剪支持“训练图偏软”的判断

- `scene_0004` 的钢珠轮廓和高光相对更清楚。
- `scene_0011` 与 `scene_0015` 的多数钢珠裁剪明显偏软，高光区域扩散。
- 用户在同一设备上的现场测试也观察到：回到偏模糊焦点时更容易识别，清晰对焦时置信度和召回率下降。

代表性裁剪：

- [scene_0004 样本](assets/scene_0004_focus_sample.png)
- [scene_0011 样本](assets/scene_0011_focus_sample.png)
- [scene_0015 样本](assets/scene_0015_focus_sample.png)

### 3. 标注噪声是次要但真实存在的风险

代表性裁剪中发现少量框落在背景边缘或只包含局部反光物体。焦点问题解决后，重新训练前仍应清理这些错误框，否则模型可能继续把背景边界或强反光当作钢珠特征。

## 范围、数据与指标

- 数据集：`datasets/combined_dataset_run_0002`
- 分析样本：3,986 个已标注钢珠框，其中训练集 3,548 个、验证集 438 个
- 清晰度代理指标：
  - 框内区域缩放至 `64×64`
  - 计算 Laplacian 方差
  - 计算 Tenengrad 梯度能量作交叉检查
- 完整可复跑分析：[focus_shift_analysis.ipynb](focus_shift_analysis.ipynb)
- 场景汇总数据：[focus_metrics_by_scene.csv](focus_metrics_by_scene.csv)

## 方法

1. 读取 YOLO 标签并还原每个钢珠框。
2. 向内收缩 8%，减少背景边缘对清晰度指标的影响。
3. 将裁剪统一缩放到 `64×64`，降低钢珠尺寸差异的影响。
4. 计算 Laplacian 方差和 Tenengrad 梯度能量。
5. 按场景汇总 P10、中位数和 P90，并人工查看确定性随机样本。

## 局限与稳健性

- Laplacian 和 Tenengrad 是相对清晰度代理，不是镜头焦点的绝对测量。
- 金属高光、曝光、JPEG 压缩、钢珠像素尺寸和背景边缘都会影响指标。
- 当前没有同一机位、同一光照、同一钢珠位置下的清晰/偏焦配对图片，因此“焦点变化导致推理变化”仍缺少严格的因果 A/B 数据。
- 本报告未绘制趋势图，因为当前最关键的缺口是标准化配对样本；在缺少该样本时，图形会放大清晰度代理指标的可比性。

## 建议的下一步

1. 将相机固定在比赛预计工作距离，先把钢珠边缘调到清晰，再用记号笔标记镜头位置并做机械防松。
2. 在同一机位采集三档焦点：
   - 清晰对焦：约 70%
   - 轻微向前偏焦：约 15%
   - 轻微向后偏焦：约 15%
3. 每档都覆盖单球、多球相邻、远近变化、不同背景和不同光照；训练集与验证集按完整采集序列隔离。
4. 清理背景边缘、手、反光物体等错误框。
5. 从当前 v2 权重继续训练，完成后重新导出 ONNX、转换 CVIModel，并在 MaixCAM 上分别测试三档焦点。
6. 不通过单纯降低阈值修复焦点域偏移；降低阈值通常会同步增加误检。

## 待验证问题

- 清晰对焦与轻微偏焦时，固定测试集上的 Precision、Recall 和平均置信度分别是多少？
- 比赛实际工作距离范围是多少，景深能否覆盖该范围？
- 镜头和相机支架在云台运动、振动后是否会发生焦点漂移？
- 清理标注噪声后，模型在清晰画面上的提升有多大？
