liuba688/diansai-simulation/output/电赛小车题设计报告可套用模板.docx

【年份】年全国大学生电子设计竞赛

【题目名称】（【题号】）设计报告

【本科组/高职高专组】

完成日期：【年】年【月】月【日】日

# 摘要

【150～250字。按“任务—架构—关键方法—实测结果—结论”写。示例：本文设计并制作了……系统以……为核心，采用……获取……，通过……算法实现……。在……条件下重复测试【n】次，平均完成时间为【】s，最大横向偏差为【】cm，识别正确率为【】%，完成基本要求【】及发挥要求【】。】

关键词：【主控】；【循迹/视觉】；【闭环控制】；【无线通信】；【小车】

# 任务与指标追踪表

赛题条目 | 量化指标/判据 | 设计措施 | 正文位置 | 测试表
基本要求(1) | 【填写】 | 【填写】 | §【】 | 表【】
基本要求(2) | 【填写】 | 【填写】 | §【】 | 表【】
基本要求(3) | 【填写】 | 【填写】 | §【】 | 表【】
发挥要求(1) | 【填写】 | 【填写】 | §【】 | 表【】
发挥要求(2) | 【填写】 | 【填写】 | §【】 | 表【】

# 1 引言

【用一段话概括任务场景；用一段话指出本题的主要技术难点；末句说明全文结构。不要复比赛题全文。】

## 1.1 任务分解

- 感知任务：【循迹线/目标/数字/距离/姿态】
- 决策任务：【路径选择/状态切换/协同规则】
- 控制任务：【速度/方向/停车/跟随】
- 约束条件：【尺寸、载荷、时间、光照、禁用器件等】

# 2 系统方案

## 2.1 总体方案

【插入“图1 系统总体框图”。正文按信号流描述：传感器→主控→算法→驱动→执行器；同时说明电源与通信。】

图1 系统总体框图（【请替换为实际图片】）

## 2.2 底盘与转向方案比较

方案 | 优点 | 不足 | 选择依据
【差速/舵机转向等】 | 【】 | 【】 | 【与题目指标相关】
【备选】 | 【】 | 【】 | 【】

## 2.3 感知方案比较

方案 | 精度 | 刷新率 | 环境适应性 | 结论
【方案A】 | 【】 | 【Hz】 | 【】 | 【】
【方案B】 | 【】 | 【Hz】 | 【】 | 选用【】

## 2.4 控制与通信方案

【比较控制器/通信方案，给出选择结论。两车协同时写清主从、握手、超时和失联策略。】

# 3 理论分析与计算

## 3.1 车辆运动学模型

对轮距为 B 的差速小车，设左右轮线速度分别为 vL、vR，则车体中心线速度和角速度为：

v = (vR + vL) / 2，ω = (vR - vL) / B。

【代入本车轮距、目标速度和最小转弯半径，计算左右轮速度范围；说明该结果如何用于电机选型与限幅。】

## 3.2 速度测量与电机参数

编码器采样周期 Δt 内计数增量为 ΔN，每圈计数为 N0、轮径为 D，则 v = πD·ΔN/(N0·Δt)。

参数 | 符号 | 数值 | 单位 | 来源/测量方法
轮径 | D | 【】 | m | 游标卡尺实测
轮距 | B | 【】 | m | 轮胎接地点中心距
编码器分辨率 | N0 | 【】 | count/r | 数据手册×减速比
控制周期 | Δt | 【】 | ms | 定时器配置
最大负载 | m | 【】 | kg | 题目载荷+车体

## 3.3 感知与误差定义

【定义图像/传感器坐标系、横向误差 e、航向误差 eθ；给出像素—实际距离标定关系或阵列传感器加权公式。插入安装尺寸图。】

## 3.4 闭环控制器

离散PID控制律可写为 u(k)=Kp·e(k)+Ki·Σe(k)·Ts+Kd·[e(k)-e(k-1)]/Ts。

【说明控制量对应差速/舵角；给出Kp、Ki、Kd、采样周期、输出限幅、抗积分饱和与整定过程。不要只写“经多次调试”。】

参数 | 数值 | 作用 | 整定依据
Kp | 【】 | 【】 | 【阶跃/临界比例/经验+实测】
Ki | 【】 | 【】 | 【】
Kd | 【】 | 【】 | 【】

## 3.5 停车距离与误差预算

【估算感知+计算+执行延迟引起的位移 v·td，以及制动距离 v²/(2a)。列出各误差源，说明是否满足停车区/边界要求并留有余量。】

误差源 | 典型值 | 最坏值 | 影响 | 抑制措施
传感器测量 | 【】 | 【】 | 【】 | 滤波/标定
轮径与安装差 | 【】 | 【】 | 【】 | 左右轮校准
控制延迟 | 【】 | 【】 | 【】 | 提高刷新率
地面/光照变化 | 【】 | 【】 | 【】 | 自适应阈值/闭环

# 4 硬件电路设计

## 4.1 总体电路与电源树

【插入清晰的总体原理图或连接框图。标注电池、稳压、主控、电机驱动、传感器、通信、声光提示。写出各电源轨最大电流和余量。】

电源轨 | 负载 | 最大电流 | 设计能力 | 余量
【电池电压】 | 电机驱动 | 【】A | 【】A | 【】%
5 V | 视觉/传感器 | 【】A | 【】A | 【】%
3.3 V | MCU/通信 | 【】A | 【】A | 【】%

## 4.2 主控及接口

【说明主控选型、时钟、ADC/PWM/UART/I²C/SPI分配；给出关键引脚表。】

## 4.3 电机驱动与保护

【给出驱动型号、PWM频率、峰值/持续电流、续流/过流/欠压措施；解释为何满足堵转或加速电流。】

## 4.4 传感与通信电路

【说明接口电平、上拉、滤波、串口波特率或无线参数；写清共地和抗干扰措施。】

# 5 软件设计

## 5.1 总体状态机

【插入“图n 主程序状态机”：初始化→目标识别→装载检测→出发→路口/路径决策→到达→卸载→返回→结束；对异常和超时给转移。】

## 5.2 感知与识别

【写输入、预处理、特征/阈值、输出、刷新率和置信度策略。给伪代码或流程图，不贴大段源码。】

## 5.3 路径决策与循迹控制

【写路径表示、路口判断、目标路径选择、误差计算、速度规划、弯道降速和丢线恢复。】

## 5.4 停车与任务判定

【说明到达标志、预减速点、停车判据、指示灯/蜂鸣器逻辑和重复触发抑制。】

## 5.5 协同通信（如适用）

消息 | 发送方→接收方 | 触发条件 | 超时/重发 | 动作
READY | 车1→车2 | 【】 | 【】ms/【】次 | 【】
START | 【】 | 【】 | 【】 | 【】
ARRIVED | 【】 | 【】 | 【】 | 【】

# 6 系统测试

## 6.1 测试环境、仪器与方法

项目 | 内容
场地 | 【尺寸、材料、线宽、弯道/路口布置】
环境 | 【照度范围】lx；【有/无顶灯变化】；温度【】℃
小车状态 | 电池【】V；载荷【】g；轮胎/传感器高度【】
仪器 | 秒表【型号/分辨率】；卷尺【】；示波器【】；照度计【】
方法 | 每项【】次；失败定义【】；先后顺序/随机化方式【】

## 6.2 基本要求测试结果

项目 | 次数 | 时间/s | 最大偏差/cm | 停车误差/cm | 结果/备注
基本(1) | 1 | 【】 | 【】 | 【】 | 成功/失败
基本(1) | 2 | 【】 | 【】 | 【】
基本(1) | 3 | 【】 | 【】 | 【】
基本(1) | 4 | 【】 | 【】 | 【】
基本(1) | 5 | 【】 | 【】 | 【】
统计 | 平均/最坏 | 【】/【】 | 【】 | 【】 | 成功率【】%

结果分析：【对照赛题阈值给结论；解释最坏一次的原因；不要只写“满足要求”。】

## 6.3 发挥要求测试结果

场景/目标 | 次数 | 关键时间/s | 识别/通信 | 偏差或距离/cm | 结论
【发挥(1)】 | 1 | 【】 | 【】 | 【】 | 【】
【发挥(1)】 | 2 | 【】 | 【】 | 【】 | 【】
【发挥(1)】 | 3 | 【】 | 【】 | 【】 | 【】
【发挥(1)】 | 4 | 【】 | 【】 | 【】 | 【】
【发挥(1)】 | 5 | 【】 | 【】 | 【】 | 【】
统计 | — | 均值【】/最坏【】 | 成功率【】% | 最坏【】 | 【】

## 6.4 鲁棒性与边界测试

变化因素 | 测试范围 | 次数 | 成功率 | 最坏指标 | 结论
照度 | 【】～【】lx | 【】 | 【】% | 【】 | 【】
电池电压 | 【】～【】V | 【】 | 【】% | 【】 | 【】
载荷 | 【】～【】g | 【】 | 【】% | 【】 | 【】
起始偏角/位置 | 【】 | 【】 | 【】% | 【】 | 【】

# 7 结论

【一段话概括系统架构；一段话列出完成的赛题条目及最关键的3个量化指标；最后用1～2句说明当前不足及可行改进。不得引入正文没有的数据。】

# 参考文献

[1] 【芯片/传感器厂商】. 【数据手册名称】[Z]. 【版本/年份】.

[2] 【作者】. 【控制/视觉算法文献题名】[J/M]. 【出处】, 【年份】.

[3] 全国大学生电子设计竞赛组委会. 【当年题目名称】[Z]. 【年份】.

# 附录A 关键器件表（按规则决定是否保留）

模块 | 型号 | 关键参数 | 数量 | 作用
主控 | 【】 | 【】 | 【】 | 【】
电机与驱动 | 【】 | 【】 | 【】 | 【】
传感器 | 【】 | 【】 | 【】 | 【】
通信 | 【】 | 【】 | 【】 | 【】

# 附录B 提交前自检

- 删除全部【填写】占位符。
- 更新目录、图表编号和页码。
- 逐项核对需求追踪表与测试表。
- 确认所有数值带单位且正文/图表一致。
- 检查是否包含当年规则禁止出现的学校或队员信息。
- 导出PDF后逐页检查图表清晰度、分页和乱码。

全国大学生电子设计竞赛 · 小车题报告工作稿
