liuba688/diansai-simulation/vision/training/analysis/assets/scene_0015_focus_sample.png

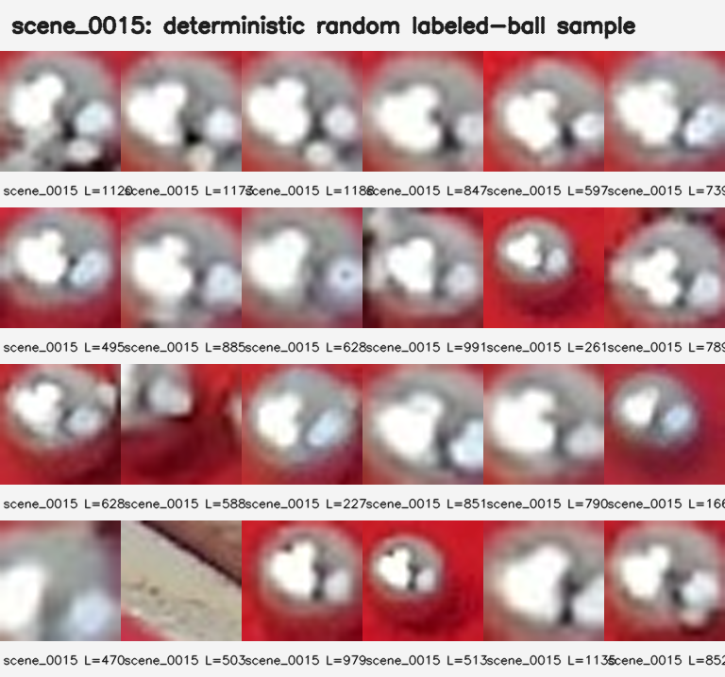
vision/training/analysis/assets/scene_0015_focus_sample.png
