liuba688/diansai-simulation/vision/h_vehicle_ball_balance/pixel_calibration_3point/README.md

# MaixCAM 三点像素标定（电机禁用）

> 本目录只用于读取 `0/+50/-50 mm` 三点的 `raw_x`。`main.py` 固定设置
> `PIXEL_CALIBRATION_ONLY=True`，控制器测试已验证电机目标始终为0。不要把本目录
> 当作第一问正式运行程序。

下方完整轨迹说明来自其控制工程母版，仅用于解释日志字段；本标定工程实际固定停留在
`PIXEL_CALIBRATION`，不会进入这些运动状态：

```text
WAIT_CENTER
  -> HOLD_CENTER
  -> POS_PUSH
  -> POS_BRAKE
  -> POS_SETTLE
  -> NEG_PUSH
  -> NEG_BRAKE
  -> NEG_SETTLE
  -> COMPLETE
```

不是只运行到 `+50 mm`。只有视觉确认球已到正端附近且速度足够低，程序才进入负向段；
最后在 `-50 mm` 持续闭环并满足稳定判据后进入 `COMPLETE`。

## 固定动作表

| 阶段 | 球杆角 | 最长时间 | 视觉提前切换条件 |
|---|---:|---:|---|
| `POS_PUSH` | `+2.20°` | `0.85 s` | `x>=+10 mm` 或 `v>=+35 mm/s` |
| `POS_BRAKE` | `-2.20°` | `0.28 s` | `x>=+42 mm` 且 `|v|<=30 mm/s` |
| `NEG_PUSH` | `-1.40°` | `0.90 s` | `x<=+25 mm` 或 `v<=-80 mm/s` |
| `NEG_BRAKE` | `+1.00°` | `1.00 s` | `x<=-42 mm` |

各阶段都有最短执行时间，避免单帧速度噪声立即触发换相。时间到仍会进入下一阶段，
因此不会停在正端不再执行。

正负端收敛使用同一简单 PD：

```text
angle = 0.045 * position_error - 0.018 * velocity
```

- 收敛角限制：`±2.20°`；
- 低速且误差超过 `5 mm` 时，最低起滚角 `1.10°`；
- 正端到点：进入 `|x-50|<=8 mm` 合格带后立即折返，不再等待静止；
- 负端完成：`|x+50|<=9 mm`、`|v|<=12 mm/s`，持续 `0.08 s`；
- 总时间限制：`5.00 s`。

所有首轮调参量集中在 `task1_timed_control.py` 文件顶部，后续按实机日志逐段修改。

## 安全边界

- 球达到 `±105 mm` 立即 `ball edge`；
- 视觉超时、电机应答异常立即回水平；
- X42S 相对上电水平位保持 `±160 pulse`；
- 最大控制角仍为已标定的 `±3°`；
- 机械硬限位、挡片和总电源急停必须保留；
- 未确认具体固件版本前不使用快速位置模式。

## 接线与标定

```text
MaixCAM A19 / UART1_TX -> X42S TTL_RX
MaixCAM A18 / UART1_RX <- X42S TTL_TX
MaixCAM GND            -> X42S GND
UART 115200 8N1，地址 1，校验字节 0x6B
```

视觉标定：

```text
+50 mm -> raw_x 212
  0 mm -> raw_x 324
-50 mm -> raw_x 435
```

连杆标定：

```text
0° -> 0 pulse
1° -> 80 pulse
3° -> 160 pulse
```

## 日志与调参

日志字段：

```text
state t raw_x x v ref rv ra angle cmd lim boost sent ack err rej fault fps
```

每次只调一个阶段：

1. `POS_PUSH` 后速度过高：减小 `+1.80°` 或缩短 `0.50 s`；
2. 正端过冲：更早进入 `POS_BRAKE`，或增大 `-2.20°`；
3. 正端停在 `+42 mm` 之前：延长正向推进或减小正向制动；
4. 负向推进不足：增大 `-1.40°` 或延长 `0.90 s`；
5. 负向过早反转：减小 `+0.55°`；
6. 越过负端仍高速：增大负向制动角或提前开始制动；
7. 最终来回振荡：优先增大速度阻尼，不增加位置比例。

`rej` 是被拒绝的单帧跳变累计数。单帧测量相对上次有效球位跳变超过
`max(12 mm, 300 mm/s × 帧间隔)` 时不进入控制；只有连续两帧落在相近新位置才重新
捕获，避免 `raw_x≈73` 一类瞬时误检触发端部故障。

下一轮必须返回从 `POS_PUSH` 到 `COMPLETE/FAULT` 的完整日志，不能只截取最后一行。

## 安装与验证

安装包：

```text
本标定目录直接由 MaixVision 以“打开文件夹/项目”运行，不使用第一问控制安装包。
```

本地已通过 `39` 项测试，包括固定动作表方向、完整状态覆盖和带视觉延迟、执行器滞后、
滚动摩擦与静摩擦的非线性仿真。仿真不能替代实机参数辨识。
