liuba688/diansai-simulation/vision/h_vehicle_ball_balance/runtime_480x96_direct_low_latency/versions/timed_full_task_v3_1_4_cal435_r3/TEST_RESULTS.md

# v3.1.4-cal435-r3 实机结果

## 第 34 次

- 结果：严格通过；
- 首次 `COMPLETE`：`4.82 s`；
- 正端最大位置：`+43.1 mm`；
- 负端最小位置：`-43.7 mm`；
- 完成时位置/速度：`-43.2 mm / +5.8 mm/s`；
- UART：`err=0`；
- 完成后：`angle=0.00°`、`cmd=0`，水平安全退出逻辑生效。

原始日志：

```text
test_logs/2026-07-31_remote_trials/task_v314_cal435_r3_trial34.log
```

本轮时间余量仅约 `0.18 s`，需要继续重复测试，不应凭单次成功定版。
