liuba688/diansai-simulation/2024赛题复现/调试日志.md

# 2024 H 题要求（4）调试日志

## 2026-07-26：第四题固件整理

### 本次改动

1. 建立独立的 2024 赛题复现工程。
2. 完成 A → C → B → D → A 状态机。
3. 因更新后巡线抗干扰过强，回退到根目录 `project` 中的更新前巡线版本。
4. 丢线行为由偏转搜索改为低速直行前探：
   - 32 RPM；
   - 约 150 ms；
   - 期间恢复黑线则继续巡线；
   - 持续无黑线则确认线端。
5. 全部主要速度提高：
   - 巡线直线 80 RPM；
   - 弯道最低 40 RPM；
   - 白场直行 55 RPM；
   - 急弯外轮 38 RPM。
6. B 点差速调整为左 28 RPM、右 82 RPM，轮速差 54 RPM，持续 1.0 s。
7. 扩展为第四题四圈循环：
   - B 点使用 28/82 RPM 转向；
   - A 点使用镜像 82/28 RPM 转向；
   - 两处轮速差均为 54 RPM；
   - 第四圈回到 A 后停车。

### 编译结果

- 工具：Keil MDK，Arm Compiler 6.24。
- 结果：0 Error(s)，0 Warning(s)。
- 已生成：
  `MSPM0G3507_Car/project/mdk/Objects/SeekFree_MSPM0G3507_Device_Library.hex`

### 实车状态

今晚未进行实车测试。所有运动参数仅完成代码配置和编译验证，不能视为赛道验证通过。

## 下次实车测试清单

### 1. 架空检查

- 烧录最新 HEX。
- 发送 `1`，确认 3 秒后两轮均为前进方向。
- 发送 `0`，确认任何状态下均能立即停车。
- 观察 UART 的 `route` 与 `lap` 是否正常输出。

### 2. B 点转向单项检查

- 先用手扶车或缩短测试路径，只观察 C → B 后的动作。
- 确认 B 点是左轮 28、右轮 82，即向预期方向转。
- 若角度不足，优先增加 `ROUTE_TURN_TICKS`，每次增加 5～10。
- 若角度过大，优先减少 `ROUTE_TURN_TICKS`。
- 若转向过程位移过大，再考虑降低两轮共同速度，同时保持 54 RPM 轮速差。

### 3. A 点下一圈转向检查

- 先把 `ROUTE_TOTAL_LAPS` 临时设为 2。
- 完成一圈后确认 A 点转向方向与 B 点相反。
- 确认转向后能直行遇到 C 点黑线。
- A、B 两处因为地面摩擦和入点姿态不同，最终可能需要拆成两个独立转向时间参数。

### 4. 单圈完整检查

- 临时把 `ROUTE_TOTAL_LAPS` 设为 1。
- 检查 A→C 直行、C→B 巡线、B 点转向、B→D 直行、D→A 巡线和 A 点停车。
- 重点观察 80 RPM 巡弧时是否冲线。

### 5. 四圈检查

- 恢复 `ROUTE_TOTAL_LAPS = 4`。
- 每次通过 A 后核对 UART `lap`：应依次为 1、2、3、4。
- 第 1～3 次到 A 后应继续；第 4 次到 A 后应停车。
- 记录每圈时间、转向偏差和电池电压。

## 建议记录表

| 次数 | 电池电压 | B 点转向时间 | A 点转向时间 | B→D 是否找到 D | A→C 是否找到 C | 巡线是否出界 | 完成圈数 | 备注 |
|---:|---:|---:|---:|---|---|---|---:|---|
| 1 |  | 1.0 s | 1.0 s |  |  |  |  |  |
| 2 |  |  |  |  |  |  |  |  |
| 3 |  |  |  |  |  |  |  |  |

## 已知风险

- 当前没有 MPU，所有转角均依赖轮速差和固定时间，受电池电压、地面摩擦、轮胎状态影响明显。
- A、B 点共用 1.0 s 转向时间，但两处实际入点方向可能不完全对称。
- 白场直行只有左右轮速度闭环，没有航向闭环，长距离可能偏航。
- 80 RPM 巡线尚未实测，建议首次落地测试时预留急停人员。
- 题目要求声光提示，但当前按硬件情况明确未实现。
