liuba688/diansai-simulation/2024赛题复现/MSPM0G3507_Car/project/user/src/main.c

/*********************************************************************************************************************
* MSPM0G3507 Opensource Library 即（MSPM0G3507 开源库）是一个基于官方 SDK 接口的第三方开源库
* Copyright (c) 2022 SEEKFREE 逐飞科技
* 
* 本文件是 MSPM0G3507 开源库的一部分
* 
* MSPM0G3507 开源库 是免费软件
* 您可以根据自由软件基金会发布的 GPL（GNU General Public License，即 GNU通用公共许可证）的条款
* 即 GPL 的第3版（即 GPL3.0）或（您选择的）任何后来的版本，重新发布和/或修改它
* 
* 本开源库的发布是希望它能发挥作用，但并未对其作任何的保证
* 甚至没有隐含的适销性或适合特定用途的保证
* 更多细节请参见 GPL
* 
* 您应该在收到本开源库的同时收到一份 GPL 的副本
* 如果没有，请参阅<https://www.gnu.org/licenses/>
* 
* 额外注明：
* 本开源库使用 GPL3.0 开源许可证协议 以上许可申明为译文版本
* 许可申明英文版在 libraries/doc 文件夹下的 GPL3_permission_statement.txt 文件中
* 许可证副本在 libraries 文件夹下 即该文件夹下的 LICENSE 文件
* 欢迎各位使用并传播本程序 但修改内容时必须保留逐飞科技的版权声明（即本声明）
* 
* 文件名称          mian
* 公司名称          成都逐飞科技有限公司
* 版本信息          查看 libraries/doc 文件夹内 version 文件 版本说明
* 开发环境          MDK 5.37
* 适用平台          MSPM0G3507
* 店铺链接          https://seekfree.taobao.com/
********************************************************************************************************************/

#include "zf_common_headfile.h"
#include "tb6612.h"
#include "wheel_encoder.h"
#include "speed_pid.h"
#include "line_sensor.h"
#include "line_follow.h"

/*
 * 2024 H 题要求（4）的无 IMU 四圈方案：
 * A->C 直行找线，C->B 巡线，B 点丢线后定时差速转向，
 * B->D 直行找线，D->A 巡线，最后在 A 点停车。
 * 所有时间均以 10 ms 主循环为单位，实车只需优先调整下面几项。
 */
#define ROUTE_SEARCH_RPM                 (55.0f)
#define ROUTE_TURN_LEFT_RPM              (28.0f)
#define ROUTE_TURN_RIGHT_RPM             (82.0f)
#define ROUTE_TURN_TICKS                 (100U)
#define ROUTE_LINE_CONFIRM_TICKS         (5U)
#define ROUTE_LOST_CONFIRM_TICKS         (15U)
#define ROUTE_TOTAL_LAPS                  (4U)

typedef enum
{
    ROUTE_WAIT_START = 0,
    ROUTE_SEARCH_A_TO_C,
    ROUTE_FOLLOW_C_TO_B,
    ROUTE_TURN_AT_B,
    ROUTE_SEARCH_B_TO_D,
    ROUTE_FOLLOW_D_TO_A,
    ROUTE_TURN_AT_A,
    ROUTE_FINISHED,
} route_state_enum;
// 打开新的工程或者工程移动了位置务必执行以下操作
// 第一步 关闭上面所有打开的文件
// 第二步 project->clean  等待下方进度条走完

// 本例程是开源库空工程 可用作移植或者测试各类内外设
// 本例程是开源库空工程 可用作移植或者测试各类内外设
// 本例程是开源库空工程 可用作移植或者测试各类内外设

// **************************** 代码区域 ****************************

static soft_iic_info_struct oled_iic;

// UART1 保留有线调试，UART3(PB2/PB3)连接板载 UART4 接口上的 HC-05。
static void car_log_write (const char *text)
{
    uart_write_string(UART_1, text);
    uart_write_string(UART_3, text);
}

// 长运行诊断只走 115200 UART1，避免 9600 HC-05 阻塞高速控制循环。
static void car_debug_write (const char *text)
{
    uart_write_string(UART_1, text);
}

// 查询 HC-05 命令。返回 1=START，-1=STOP，0=无完整有效命令。
static int8 car_bluetooth_query_command (void)
{
    static char command[16];
    static uint8 command_length = 0;
    uint8 data;

    while(uart_query_byte(UART_3, &data))
    {
        // 单字节命令优先处理，避免低速串口连续字符串超过接收 FIFO。
        if('1' == data)
        {
            command_length = 0;
            return 1;
        }
        if('0' == data)
        {
            command_length = 0;
            return -1;
        }

        if(('\r' == data) || ('\n' == data))
        {
            if(0 == command_length)
            {
                continue;
            }

            command[command_length] = '\0';
            command_length = 0;
            if(0 == strcmp(command, "START"))
            {
                return 1;
            }
            if(0 == strcmp(command, "STOP"))
            {
                return -1;
            }
            car_log_write("Unknown command. Use 1=START or 0=STOP.\r\n");
        }
        else if(command_length < (sizeof(command) - 1))
        {
            if((data >= 'a') && (data <= 'z'))
            {
                data = (uint8)(data - 'a' + 'A');
            }
            command[command_length] = (char)data;
            command_length ++;
            command[command_length] = '\0';

            // 蓝牙终端可能不发送回车；收到完整关键字后立即执行。
            if(0 == strcmp(command, "START"))
            {
                command_length = 0;
                return 1;
            }
            if(0 == strcmp(command, "STOP"))
            {
                command_length = 0;
                return -1;
            }
        }
        else
        {
            command_length = 0;
        }
    }
    return 0;
}

// SSD1306 I2C 控制字：0x00 表示后续字节为命令。
static void car_oled_write_command (uint8 command)
{
    uint8 packet[2] = {0x00, command};
    soft_iic_write_8bit_array(&oled_iic, packet, 2);
}

// 向 128x64 SSD1306 写满 1024 字节显存。
static void car_oled_fill (uint8 pattern)
{
    uint16 i;

    car_oled_write_command(0x21);    // 设置列地址
    car_oled_write_command(0x00);
    car_oled_write_command(0x7F);
    car_oled_write_command(0x22);    // 设置页地址
    car_oled_write_command(0x00);
    car_oled_write_command(0x07);

    soft_iic_start(&oled_iic);
    soft_iic_send_data(&oled_iic, oled_iic.addr << 1);
    soft_iic_send_data(&oled_iic, 0x40);       // 后续字节为显存数据
    for(i = 0; i < 1024; i ++)
    {
        soft_iic_send_data(&oled_iic, pattern);
    }
    soft_iic_stop(&oled_iic);
}

static void car_oled_show_string (uint8 page, const char *text)
{
    uint8 column = 0;
    uint8 font_index = 0;
    uint8 font_column = 0;

    car_oled_write_command(0x21);
    car_oled_write_command(0x00);
    car_oled_write_command(0x7F);
    car_oled_write_command(0x22);
    car_oled_write_command(page);
    car_oled_write_command(page);

    soft_iic_start(&oled_iic);
    soft_iic_send_data(&oled_iic, oled_iic.addr << 1);
    soft_iic_send_data(&oled_iic, 0x40);

    while(('\0' != *text) && (column <= 121))
    {
        if((*text < 32) || (*text > 126))
        {
            font_index = 0;
        }
        else
        {
            font_index = (uint8)(*text - 32);
        }

        for(font_column = 0; font_column < 6; font_column ++)
        {
            soft_iic_send_data(&oled_iic, ascii_font_6x8[font_index][font_column]);
            column ++;
        }
        text ++;
    }

    while(column < 128)
    {
        soft_iic_send_data(&oled_iic, 0x00);
        column ++;
    }
    soft_iic_stop(&oled_iic);
}

static void car_oled_init (void)
{
    // 载板 OLED：SCL=PA31，SDA=PA28；常见 SSD1306 地址为 0x3C。
    soft_iic_init(&oled_iic, 0x3C, 10, A31, A28);
    system_delay_ms(100);

    car_oled_write_command(0xAE);    // 关闭显示
    car_oled_write_command(0xD5);
    car_oled_write_command(0x80);
    car_oled_write_command(0xA8);
    car_oled_write_command(0x3F);
    car_oled_write_command(0xD3);
    car_oled_write_command(0x00);
    car_oled_write_command(0x40);
    car_oled_write_command(0x8D);
    car_oled_write_command(0x14);
    car_oled_write_command(0x20);
    car_oled_write_command(0x00);    // 水平寻址模式
    car_oled_write_command(0xA1);
    car_oled_write_command(0xC8);
    car_oled_write_command(0xDA);
    car_oled_write_command(0x12);
    car_oled_write_command(0x81);
    car_oled_write_command(0x7F);
    car_oled_write_command(0xD9);
    car_oled_write_command(0xF1);
    car_oled_write_command(0xDB);
    car_oled_write_command(0x40);
    car_oled_write_command(0xA4);
    car_oled_write_command(0xA6);
    car_oled_write_command(0xAF);    // 开启显示

    car_oled_fill(0xAA);
}

int main (void)
{
    uint8 pid_log_divider = 0;
    uint8 oled_debug_divider = 0;
    uint8 oled_debug_page = 0;
    uint8 line_follow_running = 0;
    uint8 route_line_ticks = 0;
    uint8 route_lost_ticks = 0;
    uint8 route_search_armed = 0;
    uint8 route_completed_laps = 0;
    uint16 route_turn_ticks = 0;
    route_state_enum route_state = ROUTE_WAIT_START;
    int8 bluetooth_command = 0;
    uint16 control_tick = 0;
    uint16 start_delay_tick = 0;
    int32 motor1_encoder_count = 0;
    int32 motor2_encoder_count = 0;
    int32 motor1_encoder_previous = 0;
    int32 motor2_encoder_previous = 0;
    int32 motor1_encoder_delta = 0;
    int32 motor2_encoder_delta = 0;
    int16 motor1_duty = 0;
    int16 motor2_duty = 0;
    float motor1_target_rpm = 0.0f;
    float motor2_target_rpm = 0.0f;
    speed_pid_struct motor1_pid;
    speed_pid_struct motor2_pid;
    line_sensor_data_struct line_sensor;
    line_follow_struct line_follow;
    char uart_log[192];
    char oled_line[24];

    clock_init(SYSTEM_CLOCK_80M);   // 时钟配置及系统初始化<务必保留>

    // UART1：有线调试；UART3：板载 UART4 接口，连接 HC-05。
    uart_init(UART_1, 115200, UART1_TX_B6, UART1_RX_B7);
    uart_init(UART_3, 9600, UART3_TX_B2, UART3_RX_B3);

    // 按终版载板测试要求，使用 PB16 作为 GPIO 心跳输出。
    // 使用翻转方式测试，不依赖外接 LED 是高电平点亮还是低电平点亮。

    // 载板蜂鸣器控制信号接 PA7，模块丝印确认低电平触发。
    // 默认输出高电平，确保蜂鸣器关闭。
    gpio_init(A7, GPO, 1, GPO_PUSH_PULL);

    // 外层工程切换为自有电机，速度换算固定采用商家给出的 2450 count/rev。
    tb6612_init();
    wheel_encoder_init();
    speed_pid_init(&motor1_pid);
    speed_pid_init(&motor2_pid);
    line_sensor_init();
    line_follow_init(&line_follow);

    car_oled_init();

    // PID 测试阶段停用 MPU-6500；保留原 PA7 低电平短鸣提示。
    car_log_write("2024 H4 ready. Four laps; IMU and alerts disabled.\r\n");

    // OLED 从测试图案切换为后续开发使用的状态界面。
    car_oled_fill(0x00);
    car_oled_show_string(0, "TI CAR READY");
    car_oled_show_string(2, "IMU: DISABLED");
    car_oled_show_string(4, "MODE: 2024 H4");
    car_oled_show_string(6, "SEND 1 TO START");
    car_log_write("PID gains: M1[10,1,0] M2[10,1,0].\r\n");
    car_log_write("UART1=115200, HC-05 UART3(PB2/PB3)=9600.\r\n");
    car_log_write("Gray pins: A0=PB25 A1=PB18 A2=PB21 OUT=PB22.\r\n");
    car_log_write("Send 1: wait 3 s, then run four A-C-B-D-A laps.\r\n");
    car_log_write("Send 0 at any time for immediate motor stop.\r\n");

    motor1_encoder_previous = wheel_encoder_get_count(WHEEL_ENCODER_MOTOR1);
    motor2_encoder_previous = wheel_encoder_get_count(WHEEL_ENCODER_MOTOR2);

    while(true)
    {
        system_delay_ms(SPEED_PID_BASE_PERIOD_MS);
        control_tick ++;

        bluetooth_command = car_bluetooth_query_command();
        if(bluetooth_command < 0)
        {
            line_follow_running = 0;
            route_state = ROUTE_WAIT_START;
            route_line_ticks = 0;
            route_lost_ticks = 0;
            route_search_armed = 0;
            route_completed_laps = 0;
            route_turn_ticks = 0;
            start_delay_tick = 0;
            motor1_target_rpm = 0.0f;
            motor2_target_rpm = 0.0f;
            speed_pid_set_target(&motor1_pid, 0.0f);
            speed_pid_set_target(&motor2_pid, 0.0f);
            line_follow_init(&line_follow);
            tb6612_stop_all();
            car_log_write("ACK STOP: motors stopped.\r\n");
        }
        else if(bluetooth_command > 0)
        {
            line_follow_running = 1;
            route_state = ROUTE_SEARCH_A_TO_C;
            route_line_ticks = 0;
            route_lost_ticks = 0;
            route_search_armed = 0;
            route_completed_laps = 0;
            route_turn_ticks = 0;
            start_delay_tick = 0;
            motor1_target_rpm = 0.0f;
            motor2_target_rpm = 0.0f;
            speed_pid_set_target(&motor1_pid, 0.0f);
            speed_pid_set_target(&motor2_pid, 0.0f);
            line_follow_init(&line_follow);
            motor1_encoder_previous = wheel_encoder_get_count(WHEEL_ENCODER_MOTOR1);
            motor2_encoder_previous = wheel_encoder_get_count(WHEEL_ENCODER_MOTOR2);
            tb6612_stop_all();
            car_log_write("ACK START: 3 s safety delay.\r\n");
        }

        line_sensor_read(&line_sensor);

        if(line_follow_running && (start_delay_tick < 300))
        {
            start_delay_tick ++;
        }

        // 收到 START 后先等待 3 秒，再执行第四问 A-C-B-D-A 四圈状态机。
        if(!line_follow_running || (start_delay_tick < 300))
        {
            motor1_target_rpm = 0.0f;
            motor2_target_rpm = 0.0f;
        }
        else
        {
            switch(route_state)
            {
                case ROUTE_SEARCH_A_TO_C:
                case ROUTE_SEARCH_B_TO_D:
                    motor1_target_rpm = ROUTE_SEARCH_RPM;
                    motor2_target_rpm = ROUTE_SEARCH_RPM;

                    /*
                     * 起点本身在黑线上。必须先连续离开黑线，再允许把下一次
                     * 连续见线判定为 C 或 D，避免刚启动就误切到巡线。
                     */
                    if(!line_sensor.line_valid)
                    {
                        route_line_ticks = 0;
                        if(route_lost_ticks < ROUTE_LOST_CONFIRM_TICKS)
                        {
                            route_lost_ticks ++;
                        }
                        if(route_lost_ticks >= ROUTE_LOST_CONFIRM_TICKS)
                        {
                            route_search_armed = 1;
                        }
                    }
                    else
                    {
                        route_lost_ticks = 0;
                        if(route_search_armed)
                        {
                            if(route_line_ticks < ROUTE_LINE_CONFIRM_TICKS)
                            {
                                route_line_ticks ++;
                            }
                            if(route_line_ticks >= ROUTE_LINE_CONFIRM_TICKS)
                            {
                                line_follow_init(&line_follow);
                                route_line_ticks = 0;
                                route_lost_ticks = 0;
                                route_search_armed = 0;
                                if(ROUTE_SEARCH_A_TO_C == route_state)
                                {
                                    route_state = ROUTE_FOLLOW_C_TO_B;
                                    car_log_write("C found: follow C->B.\r\n");
                                }
                                else
                                {
                                    route_state = ROUTE_FOLLOW_D_TO_A;
                                    car_log_write("D found: follow D->A.\r\n");
                                }
                            }
                        }
                    }
                    break;

                case ROUTE_FOLLOW_C_TO_B:
                case ROUTE_FOLLOW_D_TO_A:
                    line_follow_update(&line_follow, &line_sensor,
                                       &motor1_target_rpm,
                                       &motor2_target_rpm);
                    if(line_sensor.line_valid)
                    {
                        route_lost_ticks = 0;
                    }
                    else if(route_lost_ticks < ROUTE_LOST_CONFIRM_TICKS)
                    {
                        route_lost_ticks ++;
                    }

                    if(route_lost_ticks >= ROUTE_LOST_CONFIRM_TICKS)
                    {
                        route_lost_ticks = 0;
                        if(ROUTE_FOLLOW_C_TO_B == route_state)
                        {
                            route_state = ROUTE_TURN_AT_B;
                            route_turn_ticks = 0;
                            car_log_write("B reached: timed differential turn.\r\n");
                        }
                        else
                        {
                            route_completed_laps ++;
                            if(route_completed_laps >= ROUTE_TOTAL_LAPS)
                            {
                                route_state = ROUTE_FINISHED;
                                line_follow_running = 0;
                                motor1_target_rpm = 0.0f;
                                motor2_target_rpm = 0.0f;
                                car_log_write("A reached: four laps finished.\r\n");
                            }
                            else
                            {
                                route_state = ROUTE_TURN_AT_A;
                                route_turn_ticks = 0;
                                car_log_write("A reached: turn for next lap.\r\n");
                            }
                        }
                    }
                    break;

                case ROUTE_TURN_AT_B:
                    motor1_target_rpm = ROUTE_TURN_LEFT_RPM;
                    motor2_target_rpm = ROUTE_TURN_RIGHT_RPM;
                    route_turn_ticks ++;
                    if(route_turn_ticks >= ROUTE_TURN_TICKS)
                    {
                        route_state = ROUTE_SEARCH_B_TO_D;
                        route_line_ticks = 0;
                        route_lost_ticks = 0;
                        route_search_armed = 0;
                        car_log_write("Turn done: search B->D.\r\n");
                    }
                    break;

                case ROUTE_TURN_AT_A:
                    /*
                     * Mirror the B turn. The wheel-speed difference remains
                     * 54 RPM, but the direction is reversed to aim A->C.
                     */
                    motor1_target_rpm = ROUTE_TURN_RIGHT_RPM;
                    motor2_target_rpm = ROUTE_TURN_LEFT_RPM;
                    route_turn_ticks ++;
                    if(route_turn_ticks >= ROUTE_TURN_TICKS)
                    {
                        route_state = ROUTE_SEARCH_A_TO_C;
                        route_line_ticks = 0;
                        route_lost_ticks = 0;
                        route_search_armed = 0;
                        line_follow_init(&line_follow);
                        car_log_write("A turn done: search next C.\r\n");
                    }
                    break;

                case ROUTE_WAIT_START:
                case ROUTE_FINISHED:
                default:
                    motor1_target_rpm = 0.0f;
                    motor2_target_rpm = 0.0f;
                    break;
            }
        }

        speed_pid_set_target(&motor1_pid, motor1_target_rpm);
        speed_pid_set_target(&motor2_pid, motor2_target_rpm);

        if(0 == (control_tick % SPEED_PID_CONTROL_DIVIDER))
        {
            motor1_encoder_count = wheel_encoder_get_count(WHEEL_ENCODER_MOTOR1);
            motor2_encoder_count = wheel_encoder_get_count(WHEEL_ENCODER_MOTOR2);

            motor1_encoder_delta = SPEED_PID_MOTOR1_ENCODER_SIGN
                                 * (motor1_encoder_count - motor1_encoder_previous);
            motor2_encoder_delta = SPEED_PID_MOTOR2_ENCODER_SIGN
                                 * (motor2_encoder_count - motor2_encoder_previous);
            motor1_encoder_previous = motor1_encoder_count;
            motor2_encoder_previous = motor2_encoder_count;

            motor1_duty = speed_pid_update(&motor1_pid, motor1_encoder_delta,
                                           SPEED_PID_MOTOR1_KP,
                                           SPEED_PID_MOTOR1_KI,
                                           SPEED_PID_MOTOR1_KD);
            motor2_duty = speed_pid_update(&motor2_pid, motor2_encoder_delta,
                                           SPEED_PID_MOTOR2_KP,
                                           SPEED_PID_MOTOR2_KI,
                                           SPEED_PID_MOTOR2_KD);
            // 右轮：TB6612 A + MOTOR2 编码器；左轮：TB6612 B + MOTOR1(PA25/PA14)。
            tb6612_set_motor(TB6612_MOTOR_A,
                             SPEED_PID_TB6612_A_FORWARD_SIGN * motor2_duty);
            tb6612_set_motor(TB6612_MOTOR_B,
                             SPEED_PID_TB6612_B_FORWARD_SIGN * motor1_duty);
        }

        oled_debug_divider ++;
        if(10 <= oled_debug_divider)
        {
            oled_debug_divider = 0;
            if(0U == oled_debug_page)
            {
                sprintf(oled_line, "MASK:%02X CNT:%u",
                        line_sensor.mask,
                        line_sensor.active_count);
            }
            else if(1U == oled_debug_page)
            {
                sprintf(oled_line, "ERR:%4d PRE:%4d",
                        line_sensor.error,
                        line_follow.previous_error);
            }
            else if(2U == oled_debug_page)
            {
                sprintf(oled_line, "ROUTE:%u MODE:%u V:%u",
                        (unsigned int)route_state,
                        (unsigned int)line_follow.mode,
                        line_sensor.line_valid);
            }
            else
            {
                sprintf(oled_line, "B:%3d C:%4d",
                        (int)line_follow.base_rpm,
                        (int)line_follow.correction_rpm);
            }
            car_oled_show_string((uint8)(oled_debug_page * 2U), oled_line);
            oled_debug_page = (uint8)((oled_debug_page + 1U) & 0x03U);
        }

        pid_log_divider ++;
        if(100 <= pid_log_divider)
        {
            pid_log_divider = 0;
            sprintf(uart_log,
                    "H4 run=%u lap=%u route=%u mode=%u mask=%02X cnt=%u valid=%u err=%4d prev=%4d base=%3d corr=%4d target[L=%3d R=%3d] rpm100[L=%6ld R=%6ld]\r\n",
                    line_follow_running, route_completed_laps,
                    (unsigned int)route_state,
                    (unsigned int)line_follow.mode,
                    line_sensor.mask, line_sensor.active_count,
                    line_sensor.line_valid, line_sensor.error,
                    line_follow.previous_error,
                    (int)line_follow.base_rpm,
                    (int)line_follow.correction_rpm,
                    (int)motor1_target_rpm, (int)motor2_target_rpm,
                    (long)(motor1_pid.measured_rpm * 100.0f),
                    (long)(motor2_pid.measured_rpm * 100.0f));
            car_debug_write(uart_log);
        }
    }
}
