liuba688/diansai-simulation/(commit log)

2026-07-28 Update ball-car vision and pickup workflow
    Add red-box slowdown, green-box ball pursuit, blind pickup advance, magnet hold timing, white-area recovery, tests, and updated deployment documentation.
2026-07-28 Remove unrelated legacy car projects
    Keep the active MSPM0G3507 ball-car firmware and TI board schematics while removing historical 2024 reproduction, PID test, and obsolete angle/line project entries. Update documentation to point to the active project.
2026-07-29 7.29准备启动
2026-07-29 恢复并合并完整开发历程
2026-07-29 7.29巡线更新
2026-07-30 7.30完成巡线进入20s
    [run_20260730_141738.csv, run_20260730_141822.csv, run_20260730_173901.csv, run_20260730_181153.csv, run_20260730_192755.csv, run_20260730_194746.csv, run_20260730_201440.csv, run_20260730_203124.csv]
2026-07-31 相关文档更新
    [Drill_PTH_Through.DRL, Drill_PTH_Through_Via.DRL, Gerber_BoardOutlineLayer.GKO, Gerber_BottomLayer.GBL, Gerber_BottomPasteMaskLayer.GBP, Gerber_BottomSilkscreenLayer.GBO, Gerber_BottomSolderMaskLayer.GBS, Gerber_TopLayer.GTL]
2026-07-31 7.31 接近完赛，只差第六题
    [run_20260731_134353.csv, run_20260731_141457.csv]
2026-07-31 添加合作开发者的视觉方案 (vision/ 目录)
    [focus_metrics_by_scene.csv]
